PeterDarley/lightmotron/docs/df_player.png

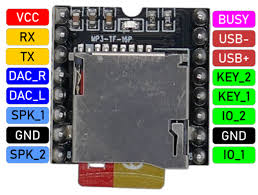
docs/df_player.png
