PeterDarley/lightmotron/docs/Logic Level Converter.png

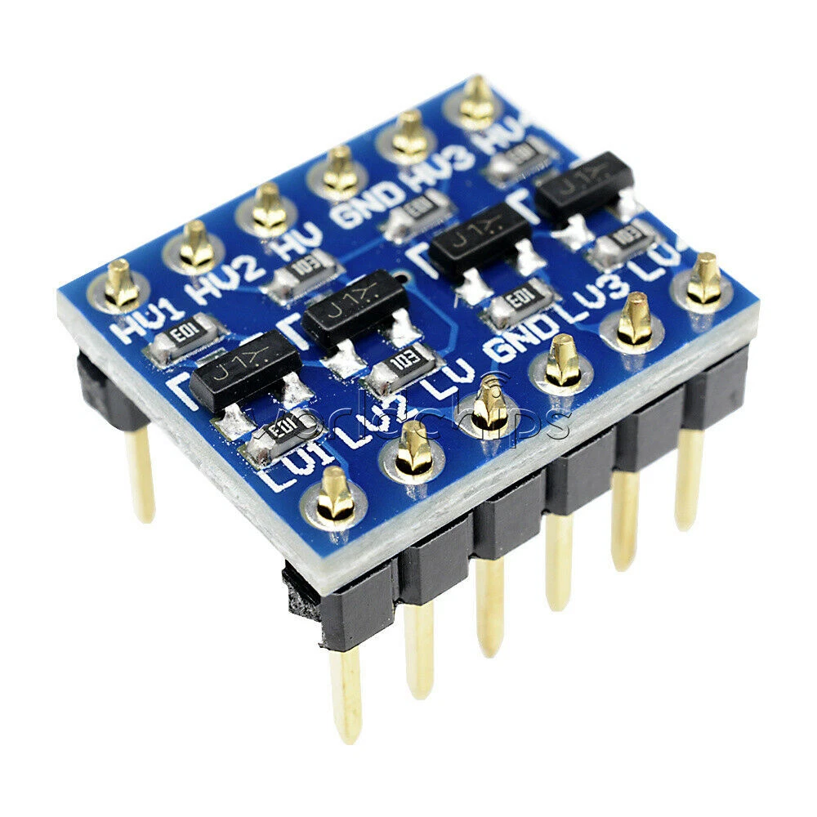
docs/Logic Level Converter.png
