PeterDarley/lightmotron/docs/single leds.png

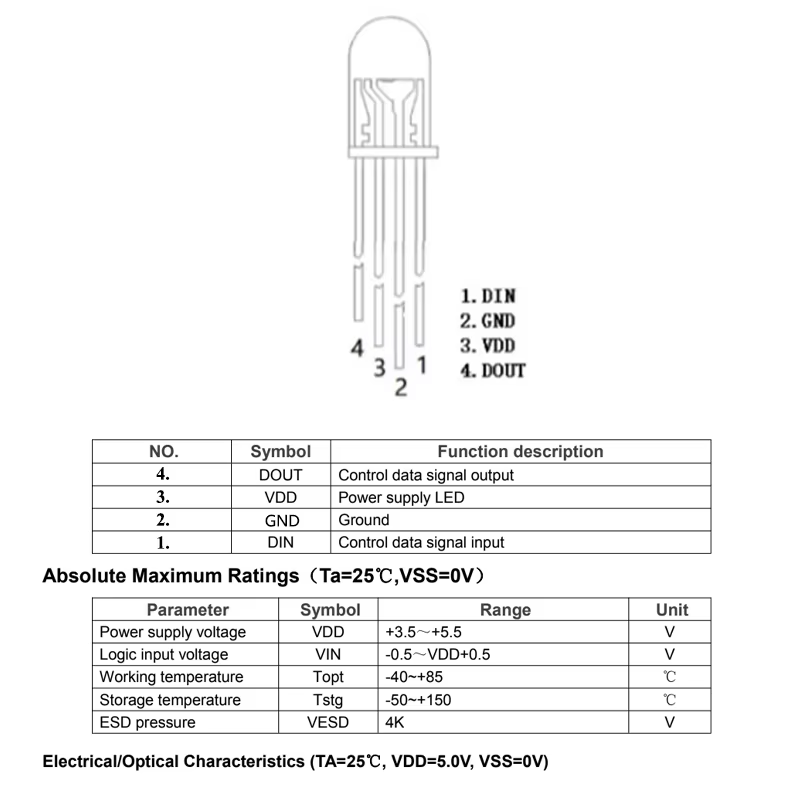
docs/single leds.png
