PeterDarley/lightmotron/docs/YD-ESP32-S3.jpg

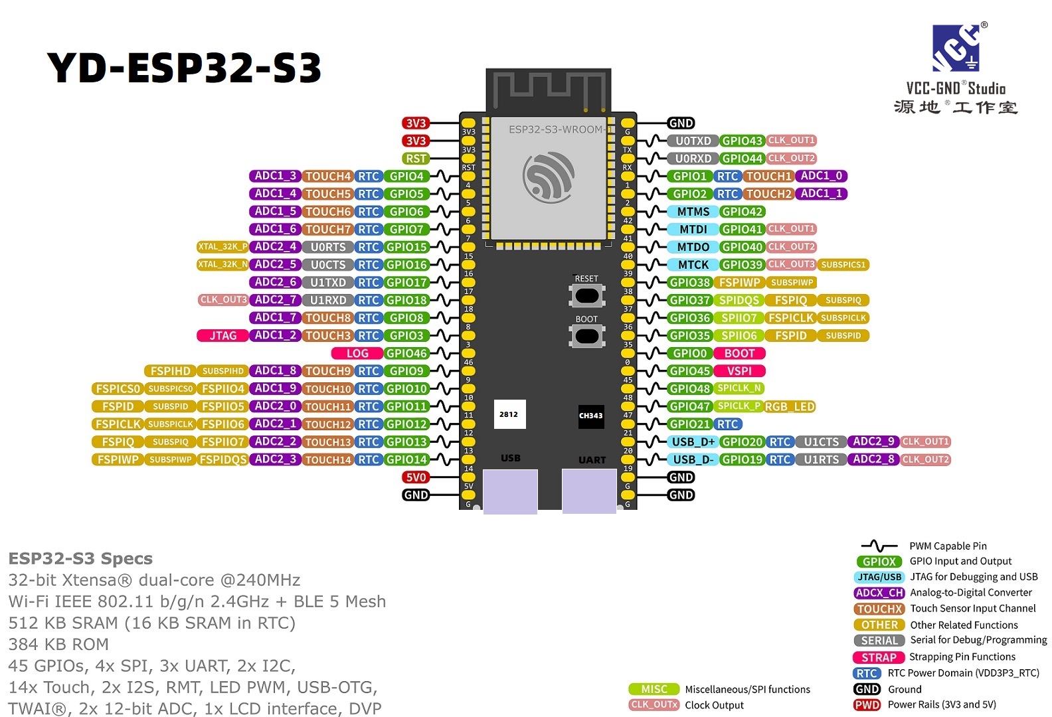
docs/YD-ESP32-S3.jpg
