PeterDarley/lightmotron/docs/bilboard wiring.jpg

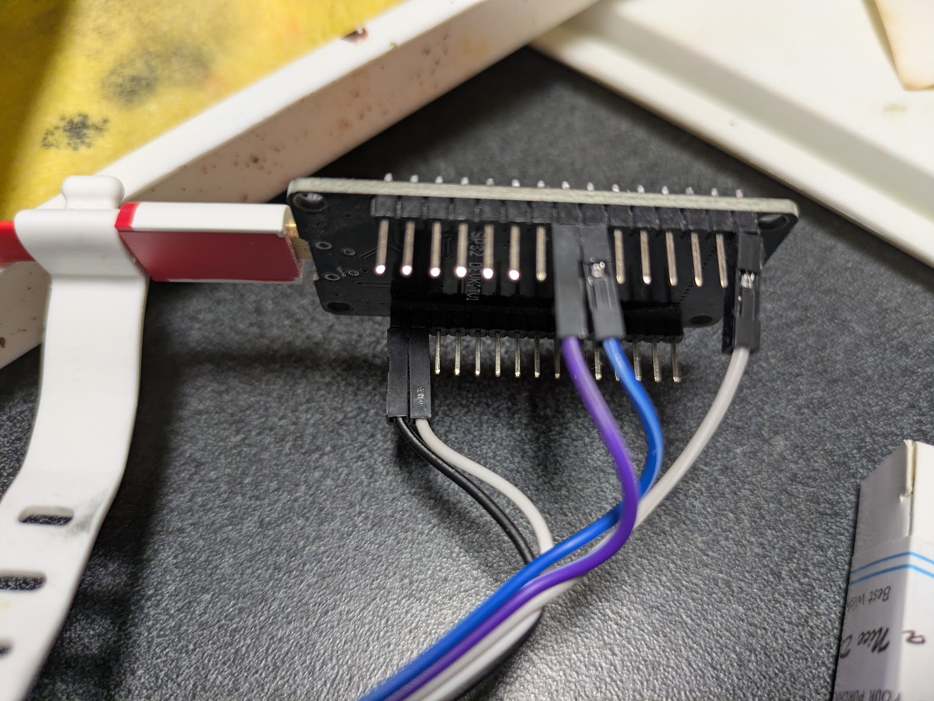
docs/bilboard wiring.jpg
