PeterDarley/lightmotron/docs/screenshots/setup-effects-edit.png

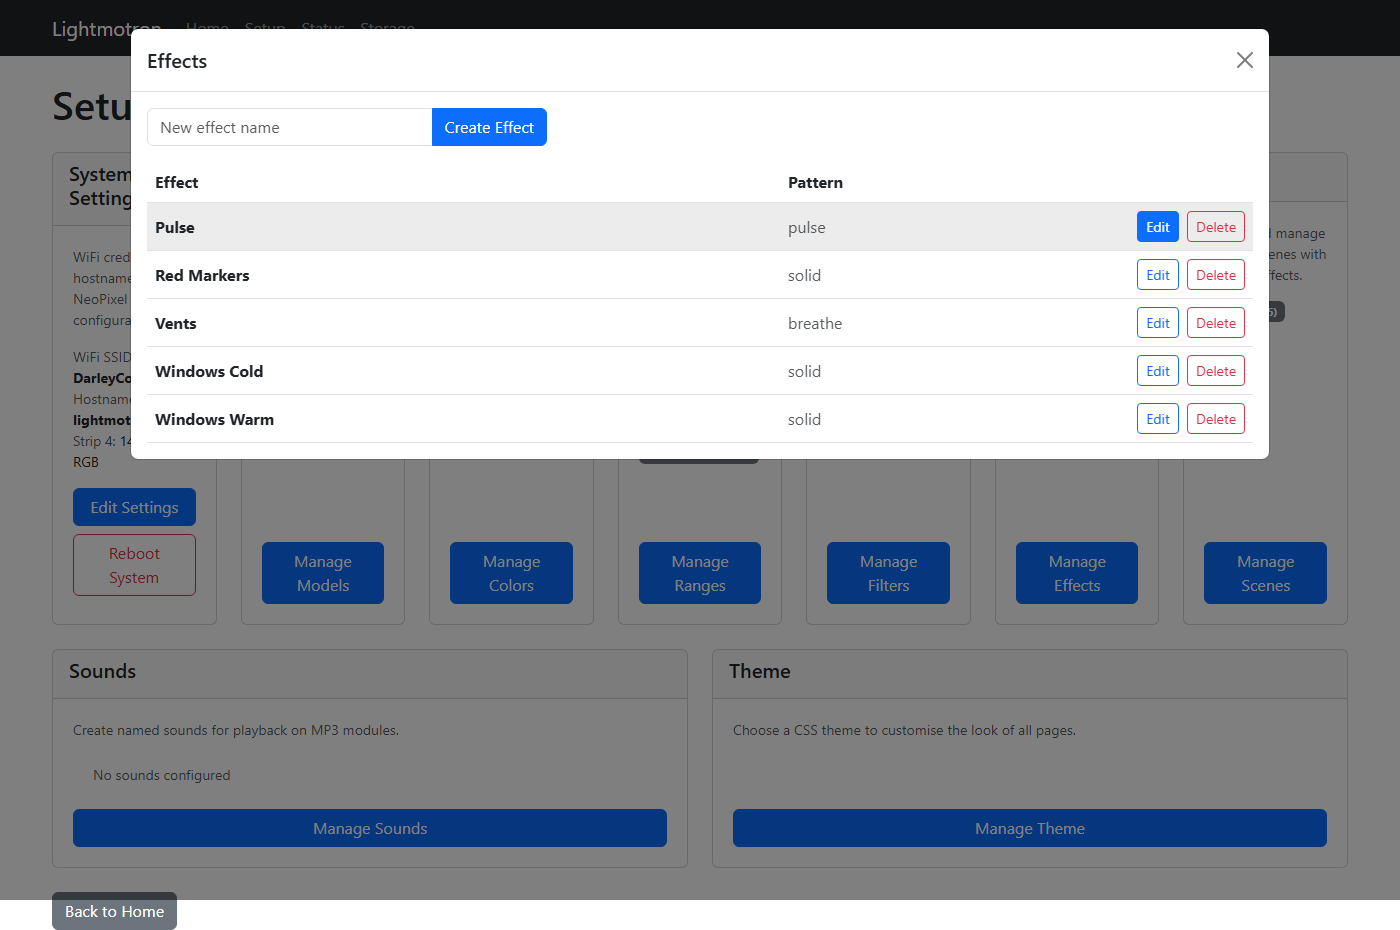
docs/screenshots/setup-effects-edit.png
