PeterDarley/lightmotron/docs/screenshots/setup-filters-edit.png

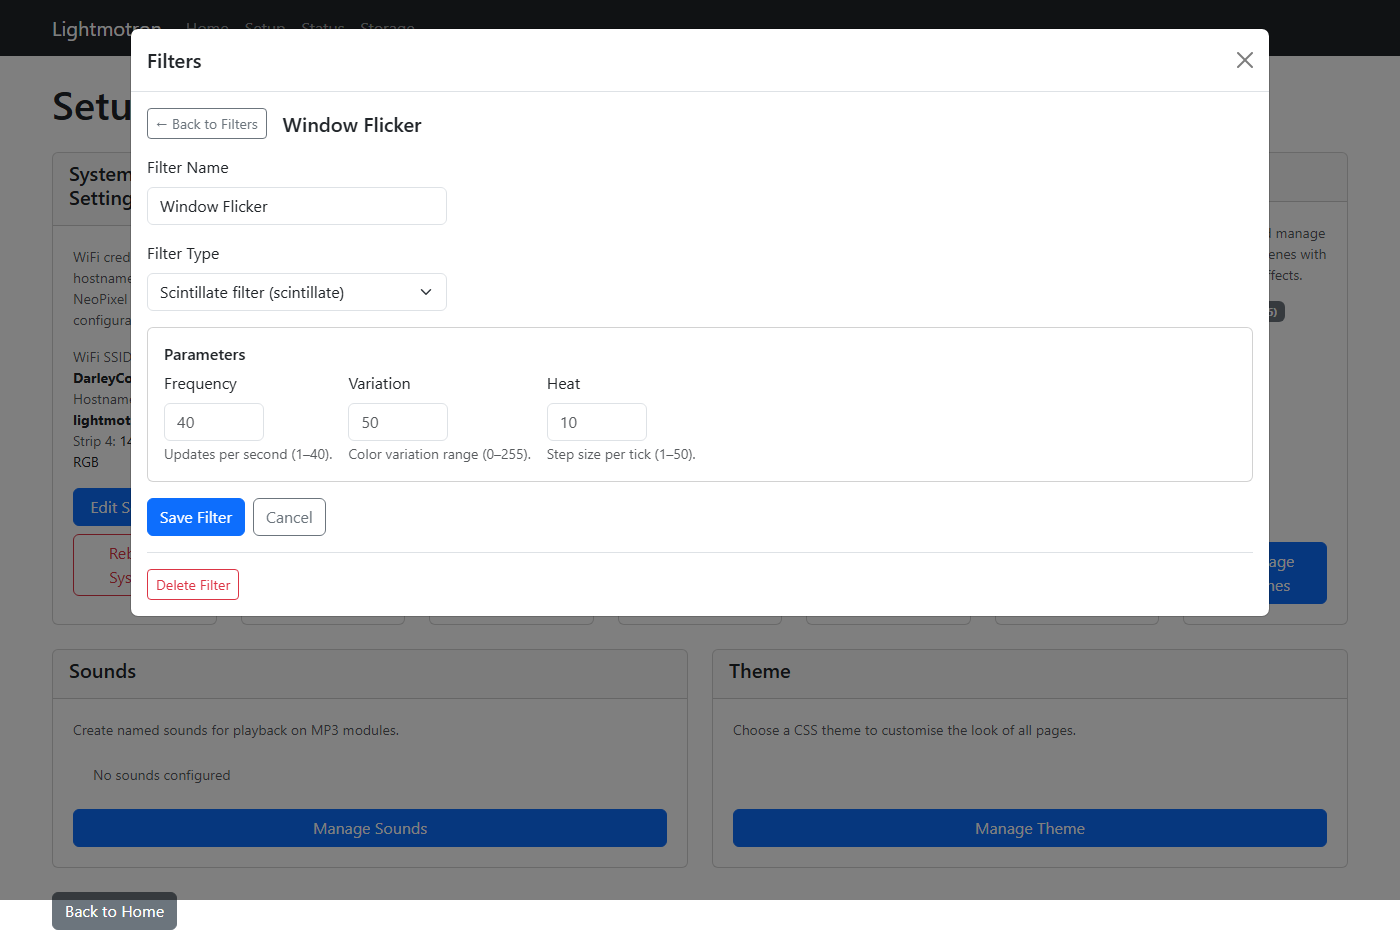
docs/screenshots/setup-filters-edit.png
