PeterDarley/lightmotron/docs/screenshots/setup-job-edit.png

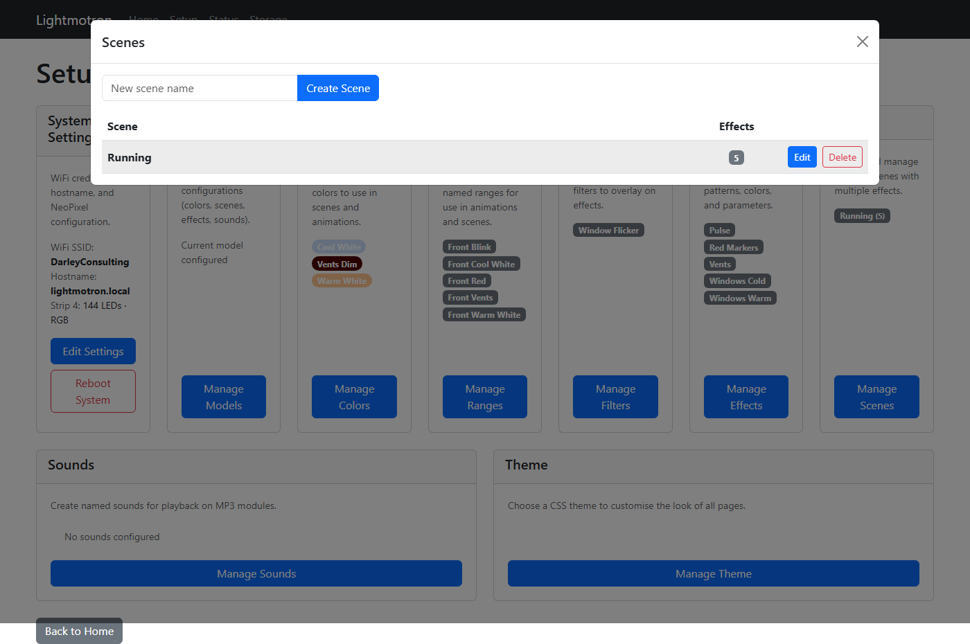
docs/screenshots/setup-job-edit.png
