PeterDarley/lightmotron/docs/screenshots/setup-ranges-edit.png

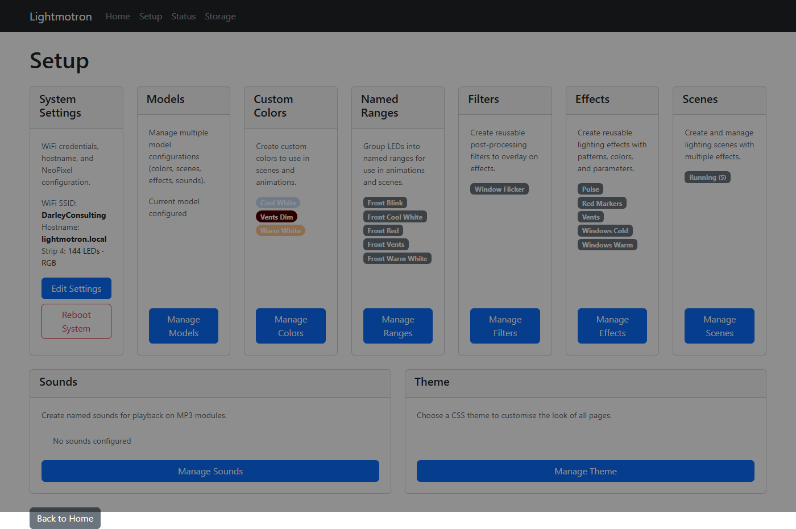
docs/screenshots/setup-ranges-edit.png
