PeterDarley/lightmotron/hardware/surface_mount/surface_mount.kicad_pcb

## KiCad design hardware/surface_mount/surface_mount.kicad_pcb (2026-11-10)

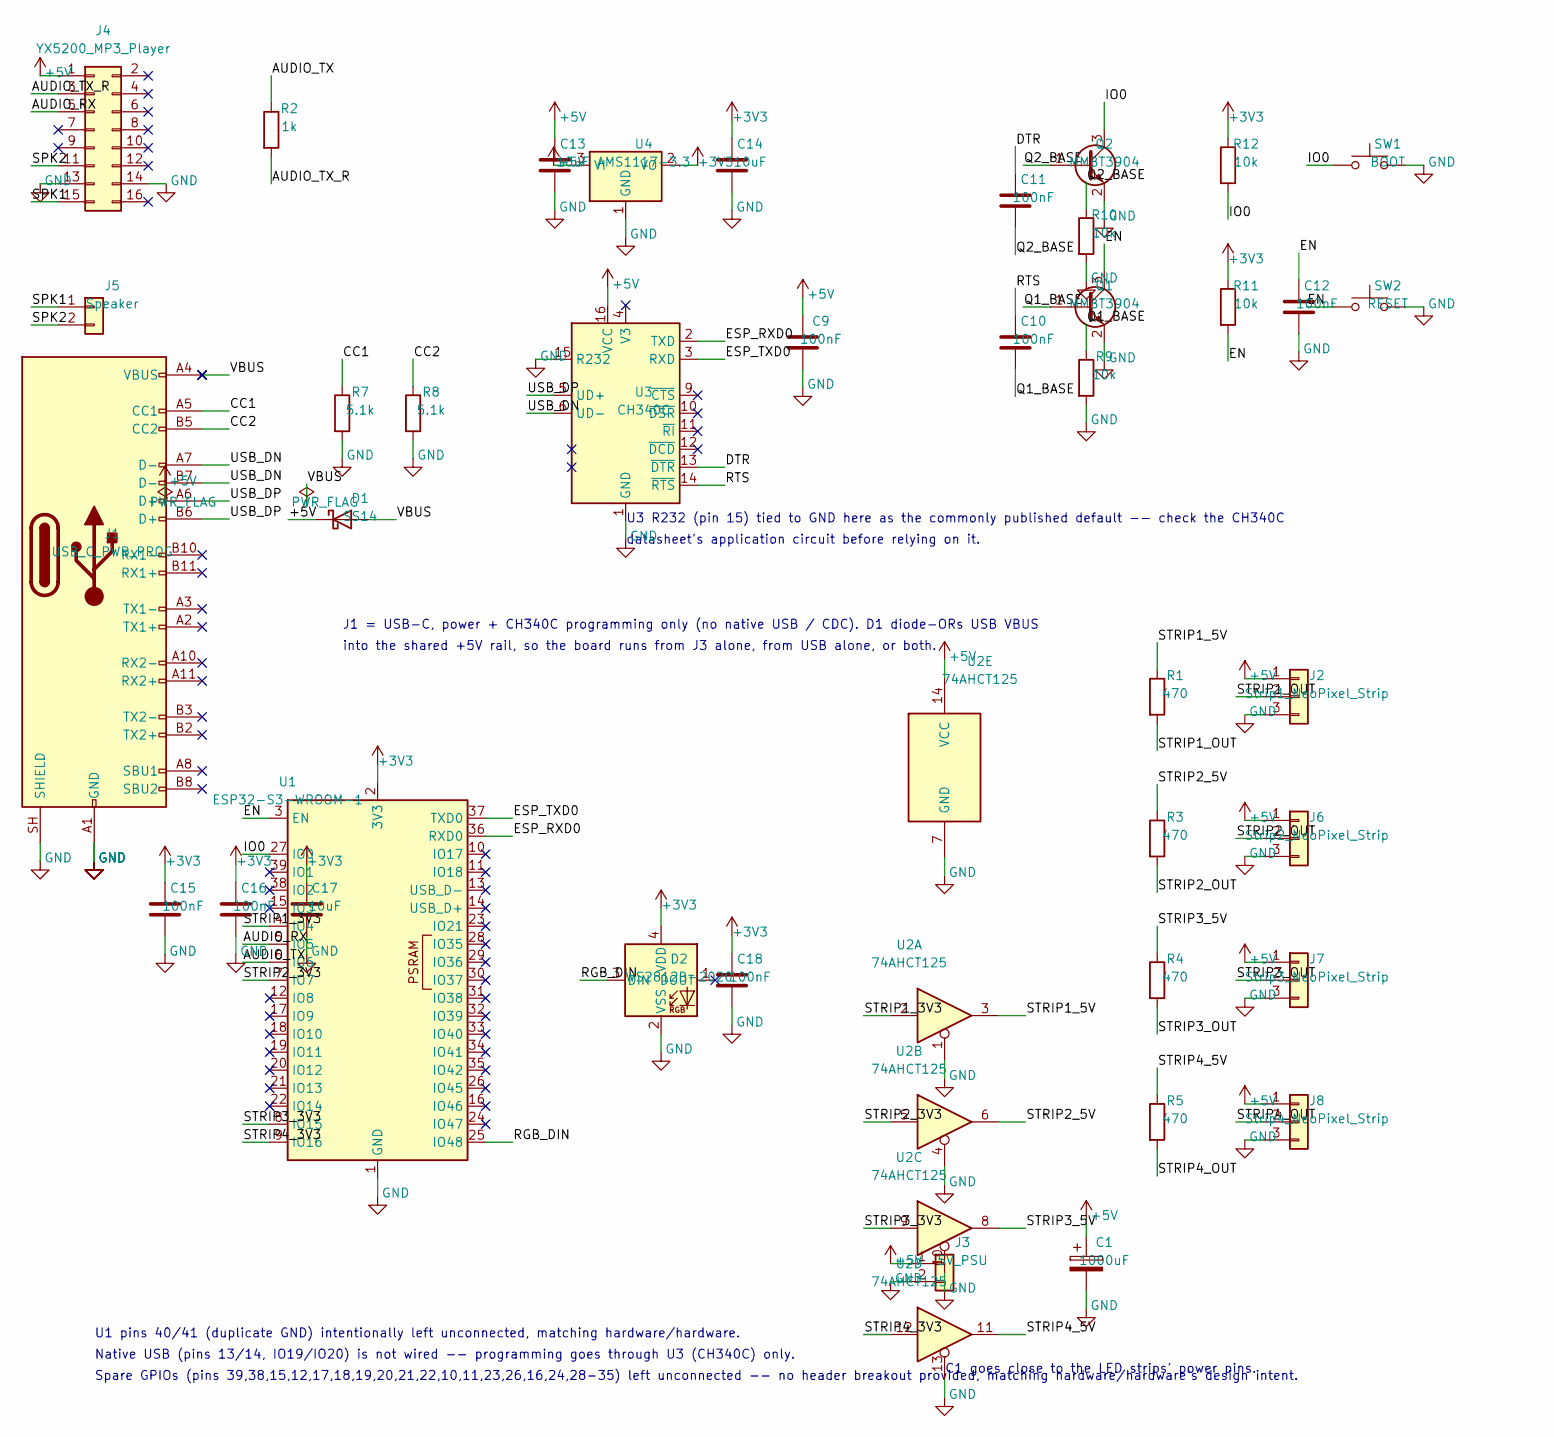
[picture p19: schematic surface_mount.kicad_sch]

Parts:
C1: 1000uF; CP_Elec_10x10.5
C9, C10, C11, C12, C15, C16, C18: 100nF; C_0603_1608Metric
C13, C14, C17: 10uF; C_0805_2012Metric
D1: SS14; D_SOD-123
D2: WS2812B-2020; LED_WS2812B-2020_PLCC4_2.0x2.0mm
J1: USB_C_PWR_PROG; USB_C_Receptacle_Amphenol_12401548E4-2A
J2: Strip1_NeoPixel_Strip; PinHeader_1x03_P2.54mm_Vertical
J3: 5V_PSU; PinHeader_1x02_P2.54mm_Vertical
J4: YX5200_MP3_Player; YX5200_DFPlayer_DIP16_W15.24mm
J5: Speaker; PinHeader_1x02_P2.54mm_Vertical
J6: Strip2_NeoPixel_Strip; PinHeader_1x03_P2.54mm_Vertical
J7: Strip3_NeoPixel_Strip; PinHeader_1x03_P2.54mm_Vertical
J8: Strip4_NeoPixel_Strip; PinHeader_1x03_P2.54mm_Vertical
Q1, Q2: MMBT3904; SOT-23
R1, R3, R4, R5: 470; R_0805_2012Metric
R2: 1k; R_0805_2012Metric
R7, R8: 5.1k; R_0805_2012Metric
R9, R10, R11, R12: 10k; R_0805_2012Metric
SW1: BOOT; Panasonic_EVQPUJ_EVQPUA
SW2: RESET; Panasonic_EVQPUJ_EVQPUA
U1: ESP32-S3-WROOM-1
U2: 74AHCT125; SOIC-14_3.9x8.7mm_P1.27mm
U3: CH340C; SOIC-16_3.9x9.9mm_P1.27mm
U4: AMS1117-3.3; SOT-223-3_TabPin2

Connections:
+3V3: C14.1, C15.1, C16.1, C17.1, C18.1, D2.4 (VDD), R11.1, R12.1, U1.2 (3V3), U4.2 (VO)
/AUDIO_RX: J4.5, U1.5 (IO5)
/AUDIO_TX: R2.1, U1.6 (IO6)
/AUDIO_TX_R: J4.3, R2.2
/CC1: J1.A5 (CC1), R7.1
/CC2: J1.B5 (CC2), R8.1
/DTR: C11.1, U3.13 (~DTR)
/EN: C12.1, Q1.3 (C), R11.2, SW2.1, U1.3 (EN)
/ESP_RXD0: U1.36 (RXD0), U3.2 (TXD)
/ESP_TXD0: U1.37 (TXD0), U3.3 (RXD)
/IO0: Q2.3 (C), R12.2, SW1.1, U1.27 (IO0)
/Q1_BASE: C10.2, Q1.1 (B), R9.1
/Q2_BASE: C11.2, Q2.1 (B), R10.1
/RGB_DIN: D2.3 (DIN), U1.25 (IO48)
/RTS: C10.1, U3.14 (~RTS)
/SPK1: J4.15, J5.1
/SPK2: J4.11, J5.2
/STRIP1_3V3: U1.4 (IO4), U2.2
/STRIP1_5V: R1.1, U2.3
/STRIP1_OUT: J2.2, R1.2
/STRIP2_3V3: U1.7 (IO7), U2.5
/STRIP2_5V: R3.1, U2.6
/STRIP2_OUT: J6.2, R3.2
/STRIP3_3V3: U1.8 (IO15), U2.9
/STRIP3_5V: R4.1, U2.8
/STRIP3_OUT: J7.2, R4.2
/STRIP4_3V3: U1.9 (IO16), U2.12
/STRIP4_5V: R5.1, U2.11
/STRIP4_OUT: J8.2, R5.2
/USB_DN: J1.A7 (D-), J1.B7 (D-), U3.6 (UD-)
/USB_DP: J1.A6 (D+), J1.B6 (D+), U3.5 (UD+)
GND: C1.2, C9.2, C12.2, C13.2, C14.2, C15.2, C16.2, C17.2, C18.2, D2.2 (VSS), J1.A1 (GND), J1.A12 (GND), J1.B1 (GND), J1.B12 (GND), J1.SH (SHIELD), J2.3, J3.2, J4.13, J4.14, J6.3, J7.3, J8.3, Q1.2 (E), Q2.2 (E), R7.2, R8.2, R9.2, R10.2, SW1.2, SW2.2, U1.1 (GND), U1.40 (GND), U1.41 (GND), U2.1, U2.4, U2.7 (GND), U2.10, U2.13, U3.1 (GND), U3.15 (R232), U4.1 (GND)

Notes on the sheet:
J1 = USB-C, power + CH340C programming only (no native USB / CDC). D1 diode-ORs USB VBUS
into the shared +5V rail, so the board runs from J3 alone, from USB alone, or both.
U3 R232 (pin 15) tied to GND here as the commonly published default -- check the CH340C
datasheet's application circuit before relying on it.
U1 pins 40/41 (duplicate GND) intentionally left unconnected, matching hardware/hardware.
Native USB (pins 13/14, IO19/IO20) is not wired -- programming goes through U3 (CH340C) only.
Spare GPIOs (pins 39,38,15,12,17,18,19,20,21,22,10,11,23,26,16,24,28-35) left unconnected -- no header breakout provided, matching hardware/hardware's design intent.
C1 goes close to the LED strips' power pins.

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
Board: 2 copper layers, 36 parts (0 on the bottom side), 26 nets, no tracks yet.
