PeterDarley/lightmotron/hardware/hardware/hardware.kicad_pcb

## KiCad design hardware/hardware/hardware.kicad_pcb (2026-11-10)

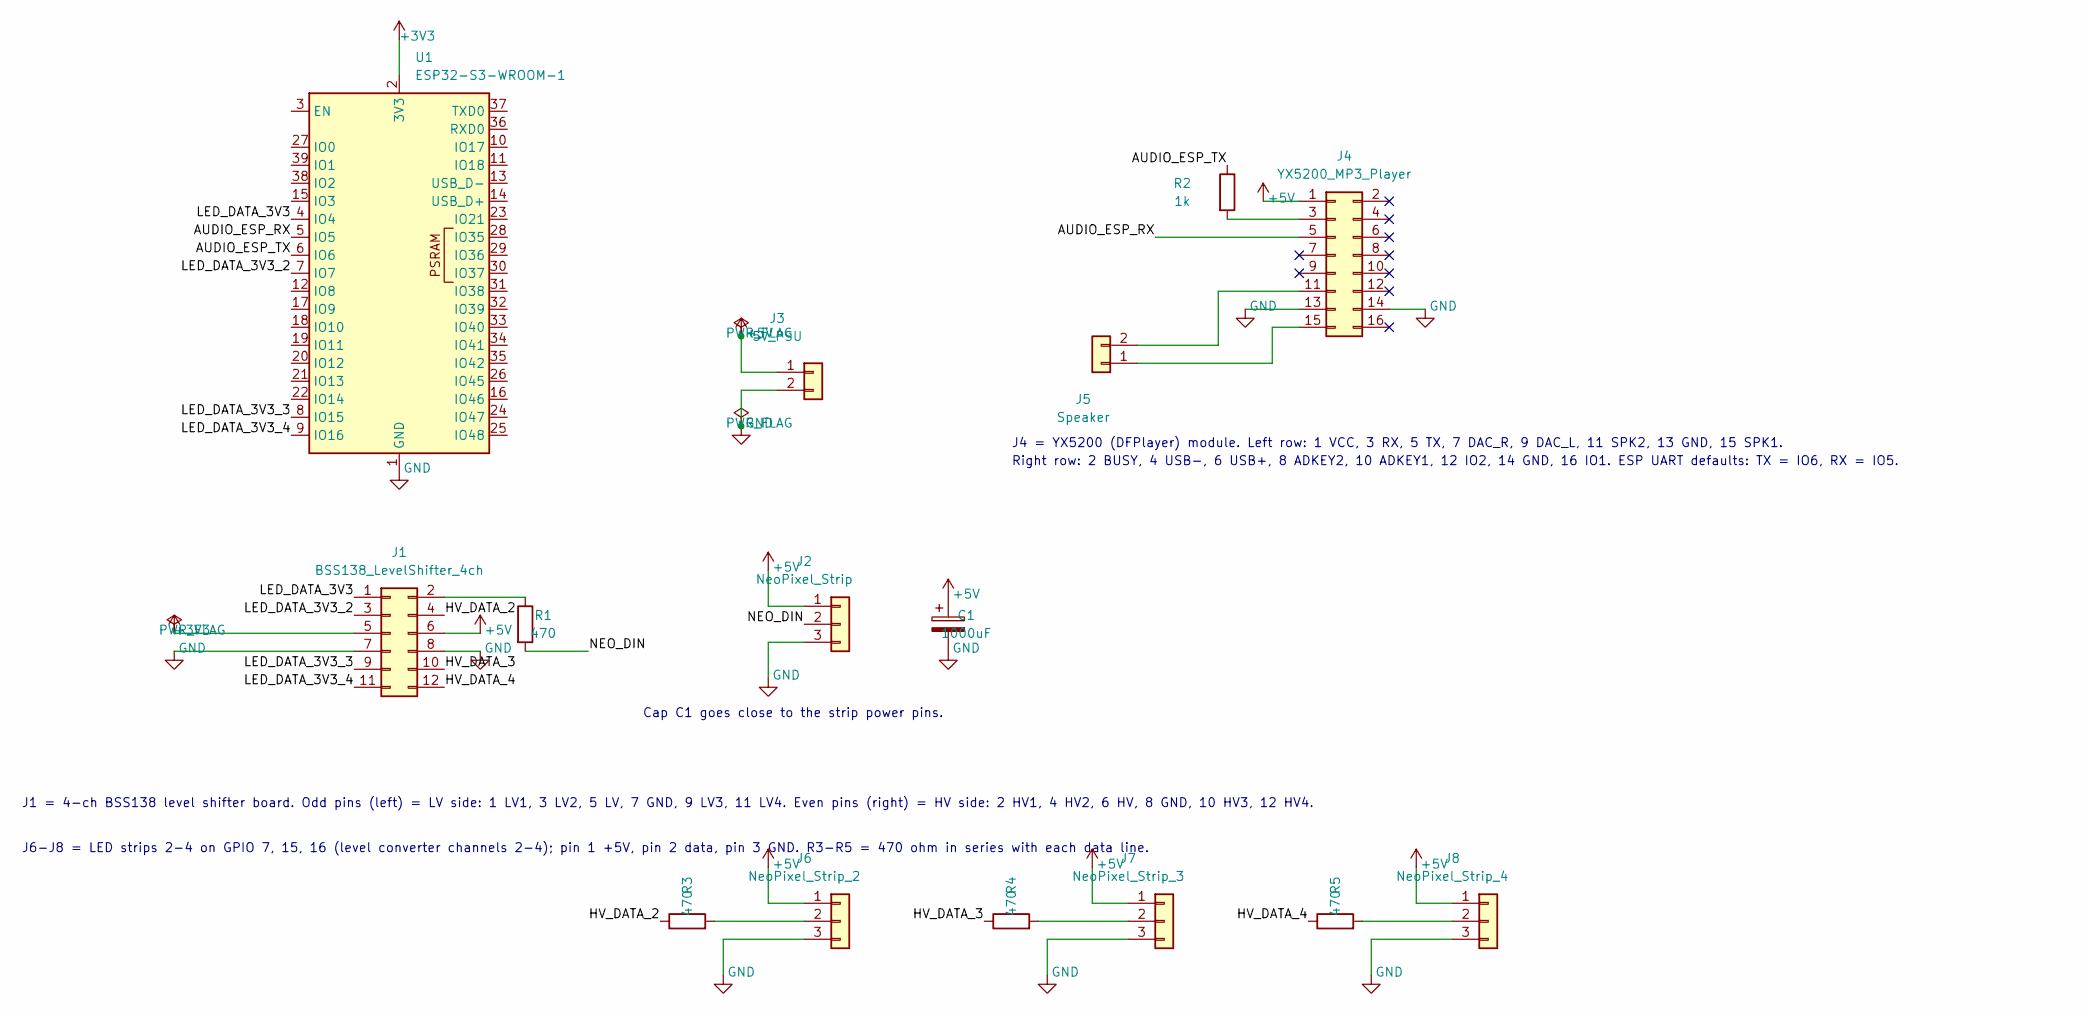
[picture p20: schematic hardware.kicad_sch]

Parts:
C1: 1000uF; CP_Radial_D10.0mm_P5.00mm
J1: BSS138_LevelShifter_4ch; BSS138_LevelShifter_4ch_2x06_P2.54mm_Row10.16mm
J2: NeoPixel_Strip; PinHeader_1x03_P2.54mm_Vertical
J3: 5V_PSU; PinHeader_1x02_P2.54mm_Vertical
J4: YX5200_MP3_Player; YX5200_DFPlayer_DIP16_W15.24mm
J5: Speaker; PinHeader_1x02_P2.54mm_Vertical
J6: NeoPixel_Strip_2; PinHeader_1x03_P2.54mm_Vertical
J7: NeoPixel_Strip_3; PinHeader_1x03_P2.54mm_Vertical
J8: NeoPixel_Strip_4; PinHeader_1x03_P2.54mm_Vertical
R1, R3, R4, R5: 470; R_Axial_DIN0207_L6.3mm_D2.5mm_P10.16mm_Horizontal
R2: 1k; R_Axial_DIN0207_L6.3mm_D2.5mm_P10.16mm_Horizontal
U1: ESP32-S3-WROOM-1; YD-ESP32-S3_DevKit_2x22_P2.54mm

Connections:
+3V3: J1.5, U1.2 (3V3)
+5V: C1.1, J1.6, J2.1, J3.1, J4.1, J6.1, J7.1, J8.1
/AUDIO_ESP_RX: J4.5, U1.5 (IO5)
/AUDIO_ESP_TX: R2.1, U1.6 (IO6)
/HV_DATA_2: J1.4, R3.1
/HV_DATA_3: J1.10, R4.1
/HV_DATA_4: J1.12, R5.1
/LED_DATA_3V3: J1.1, U1.4 (IO4)
/LED_DATA_3V3_2: J1.3, U1.7 (IO7)
/LED_DATA_3V3_3: J1.9, U1.8 (IO15)
/LED_DATA_3V3_4: J1.11, U1.9 (IO16)
/NEO_DIN: J2.2, R1.2
GND: C1.2, J1.7, J1.8, J2.3, J3.2, J4.13, J4.14, J6.3, J7.3, J8.3, U1.1 (GND), U1.40 (GND), U1.41 (GND)
unnamed: J1.2, R1.1
unnamed: J4.3, R2.2
unnamed: J4.11, J5.2
unnamed: J4.15, J5.1
unnamed: J6.2, R3.2
unnamed: J7.2, R4.2
unnamed: J8.2, R5.2

Notes on the sheet:
J1 = 4-ch BSS138 level shifter board. Odd pins (left) = LV side: 1 LV1, 3 LV2, 5 LV, 7 GND, 9 LV3, 11 LV4. Even pins (right) = HV side: 2 HV1, 4 HV2, 6 HV, 8 GND, 10 HV3, 12 HV4.
Cap C1 goes close to the strip power pins.
J4 = YX5200 (DFPlayer) module. Left row: 1 VCC, 3 RX, 5 TX, 7 DAC_R, 9 DAC_L, 11 SPK2, 13 GND, 15 SPK1.
Right row: 2 BUSY, 4 USB-, 6 USB+, 8 ADKEY2, 10 ADKEY1, 12 IO2, 14 GND, 16 IO1. ESP UART defaults: TX = IO6, RX = IO5.
J6-J8 = LED strips 2-4 on GPIO 7, 15, 16 (level converter channels 2-4); pin 1 +5V, pin 2 data, pin 3 GND. R3-R5 = 470 ohm in series with each data line.

Board: 2 copper layers, 15 parts (0 on the bottom side), 20 nets, no tracks yet.
