PeterDarley/lightmotron/c_project/components/lighting/lighting.c

#include "lighting.h"
#include "patterns.h"
#include "filters.h"
#include "effects.h"
#include "colors.h"
#include "named_ranges.h"
#include "range_topology.h"
#include "metadata.h"
#include "animation.h"
#include "persistent_dict.h"
#include "json_helpers.h"
#include "sound_manager.h"
#include "esp_log.h"
#include "freertos/FreeRTOS.h"
#include "freertos/semphr.h"

#include <string.h>
#include <stdlib.h>

static const char *TAG = "lighting";

/* LED/scene debug logging (below, in lighting_process_tick()) -- flip to 1 to
 * re-enable without having to reconstruct it. Added for LED hardware
 * bring-up, the stuck-scene-chain investigation, and the "first click
 * doesn't start the scene" report (root cause of the last one:
 * activate_scene() never taking lighting_mutex, see the "Create active
 * scene" comment below -- fixed and confirmed). Off by default again. */
#define LED_DEBUG_ENABLED 0

/* Heap-allocated (lands in external PSRAM via CONFIG_SPIRAM_USE_MALLOC,
 * since MAX_ACTIVE_SCENES * MAX_JOBS_PER_SCENE * MAX_LEDS target_indices
 * arrays are far too large for internal DRAM). */
static active_scene_t *active_scenes = NULL;
static int active_scene_count = 0;
static rgb_t logical_colors[MAX_LEDS];
static SemaphoreHandle_t lighting_mutex = NULL;
static bool initialized = false;

/* Pre-allocated buffers for tick processing (avoids per-frame stack/heap alloc) */
static led_output_t tick_output_buf[MAX_LEDS];
static rgb_t tick_filter_buf[MAX_LEDS];
static rgb_t tick_pattern_current_buf[MAX_LEDS];

esp_err_t lighting_init(void)
{
    if (initialized) return ESP_OK;

    active_scenes = calloc(MAX_ACTIVE_SCENES, sizeof(active_scene_t));
    if (!active_scenes) {
        ESP_LOGE(TAG, "Failed to allocate active_scenes (%u bytes)",
                 (unsigned)(MAX_ACTIVE_SCENES * sizeof(active_scene_t)));
        return ESP_ERR_NO_MEM;
    }

    lighting_mutex = xSemaphoreCreateMutex();
    if (!lighting_mutex) {
        ESP_LOGE(TAG, "Failed to create lighting_mutex");
        free(active_scenes);
        active_scenes = NULL;
        return ESP_ERR_NO_MEM;
    }
    memset(logical_colors, 0, sizeof(logical_colors));
    active_scene_count = 0;
    initialized = true;

    ESP_LOGI(TAG, "Lighting system initialized");
    return ESP_OK;
}

/**
 * Open the lighting-settings persistent store. Thin wrapper around the
 * shared STORAGE_LIGHTING_SETTINGS_FILE constant so every call site here
 * doesn't repeat the raw persistent_dict_open() call.
 */
static persistent_dict_t *open_lighting_store(void)
{
    return persistent_dict_open(STORAGE_LIGHTING_SETTINGS_FILE);
}

/**
 * Open the lighting settings store and return the currently-active model
 * object. Returns NULL if the store, models map, or current model is
 * missing.
 */
static cJSON *get_current_model_object(void)
{
    persistent_dict_t *lighting_store = open_lighting_store();
    if (!lighting_store) return NULL;

    cJSON *models = persistent_dict_get(lighting_store, "models");
    cJSON *current_name = persistent_dict_get(lighting_store, "current_model");
    if (!models || !current_name || !current_name->valuestring) return NULL;

    return cJSON_GetObjectItem(models, current_name->valuestring);
}

/**
 * Return true if every effect in the scene has an explicit cycle limit and
 * all of them have finished (mirrors Lighting._is_scene_finished()). A scene
 * with no cycle-limited effects at all (or none yet resolved) is never
 * considered finished.
 */
static bool scene_is_finished(const active_scene_t *scene)
{
    bool has_cycle_limited = false;

    for (int j = 0; j < scene->job_count; j++) {
        const active_job_t *job = &scene->jobs[j];
        if (job->target_count == 0) continue;

        if (job->cycles <= 0) {
            /* Infinite effect: scene is ongoing by design. */
            return false;
        }

        has_cycle_limited = true;
        if (!job->finished) return false;
    }

    return has_cycle_limited;
}

/**
 * Free a job's per-filter cJSON params/cached_params and null the pointers
 * out. Shared by every place that tears down a job's filter chain (a scene
 * finishing naturally, being explicitly removed, or all scenes being
 * cleared).
 */
static void free_job_filters(active_job_t *job)
{
    for (int f = 0; f < job->filter_count; f++) {
        if (job->filters[f].params) {
            cJSON_Delete(job->filters[f].params);
            job->filters[f].params = NULL;
        }
        if (job->filters[f].state.cached_params) {
            cJSON_Delete(job->filters[f].state.cached_params);
            job->filters[f].state.cached_params = NULL;
        }
        if (job->filters[f].state.per_led_deviation) {
            free(job->filters[f].state.per_led_deviation);
            job->filters[f].state.per_led_deviation = NULL;
            job->filters[f].state.per_led_deviation_count = 0;
        }
    }
}

/**
 * Resolve scene_name to an actual scene key, falling back to the model's
 * "default_scene" and then to the first defined scene (mirrors
 * Lighting.set_scene()'s None-name resolution). Returns NULL if no scene
 * could be resolved.
 */
static const char *resolve_scene_name(const cJSON *model, const char *scene_name, cJSON *scenes)
{
    if (scene_name) return scene_name;

    const char *default_scene = json_get_string(model, "default_scene", NULL);
    if (default_scene && cJSON_GetObjectItem(scenes, default_scene)) {
        return default_scene;
    }

    cJSON *first = scenes->child;
    return first ? first->string : NULL;
}

/**
 * Resolve one scene job entry (a named-effect reference plus overrides, or an
 * inline effect) into `job`. Shared by scene activation and by the live
 * refresh of running jobs below, so both build a job identically.
 */
static void resolve_job_entry(const cJSON *job_entry, const cJSON *effects_dict,
                              const cJSON *filters_dict, active_job_t *job)
{
    /* Check if this references a named effect or is inline */
    const char *effect_ref = json_get_string(job_entry, "effect", NULL);
    if (effect_ref && effects_dict) {
        cJSON *effect_def = cJSON_GetObjectItem(effects_dict, effect_ref);
        if (effect_def) {
            effect_resolve(effect_def, filters_dict, job);
        }
        /* Override with inline params */
        const char *target = json_get_string(job_entry, "target", NULL);
        if (target) {
            if (pattern_is_2d(job->pattern_name)) {
                if (strncmp(target, "named:", 6) == 0) {
                    range_topology_resolve(target + 6, job);
                } else {
                    job->target_count = 0;
                }
            } else {
                job->target_count = target_spec_resolve(target, job->target_indices, MAX_LEDS);
            }
        }
        int cycles = json_get_int(job_entry, "cycles", -1);
        if (cycles >= 0) job->cycles = cycles;

        const char *after = json_get_string(job_entry, "after", NULL);
        if (after) strncpy(job->after, after, sizeof(job->after) - 1);
        job->inherit_target = json_get_bool(job_entry, "inherit_target", false);
    } else {
        effect_resolve_inline(job_entry, filters_dict, job);
    }

    /* Set after effect_resolve()/effect_resolve_inline() -- both start
     * with memset(job, 0, sizeof(*job)), which would otherwise wipe this
     * right back out. Other jobs' "after" dependency lookups match on
     * this name (strcmp against scene->jobs[d].name), so it must survive
     * job resolution intact. */
    strncpy(job->name, job_entry->string, sizeof(job->name) - 1);
}

/* ---------------------------------------------------------------------
 * Live refresh of running jobs
 *
 * A running job holds a *resolved copy* of its scene entry, effect, filters
 * and colors, made when the scene started. Editing any of those in the Setup
 * UI only changes the stored settings, so without this a running scene kept
 * using its old copy until restarted. lighting_process_tick() compares the
 * lighting store's change counter (persistent_dict_version) every tick and,
 * when it moved, re-resolves every running job from the current settings and
 * merges the new *definition* into the live job -- keeping its *runtime*
 * state (start tick, finished flag, dependency state, per-filter animation
 * state) so nothing restarts.
 * ------------------------------------------------------------------- */

static active_job_t refresh_tmp;      /* scratch; only used with lighting_mutex held */
static persistent_dict_t *s_lighting_store_cached = NULL;
static uint32_t s_seen_settings_version = 0;

static void merge_job_definition(active_job_t *job, active_job_t *fresh)
{
    /* Filters: the old cJSON params are always replaced. Per-filter runtime
     * state (spike/dropout timing, sizzle/scintillate deviations) carries over
     * when the filter at the same position is still the same type, so a
     * parameter tweak doesn't reset the animation. A dropout's cached_params
     * is derived from params, so it's dropped to be rebuilt from the new ones. */
    for (int f = 0; f < job->filter_count; f++) {
        filter_state_t *old_state = &job->filters[f].state;
        if (job->filters[f].params) {
            cJSON_Delete(job->filters[f].params);
            job->filters[f].params = NULL;
        }
        if (old_state->cached_params) {
            cJSON_Delete(old_state->cached_params);
            old_state->cached_params = NULL;
        }

        bool carry = f < fresh->filter_count &&
                     strcmp(job->filters[f].filter_name, fresh->filters[f].filter_name) == 0;
        if (carry) {
            fresh->filters[f].state = *old_state; /* takes over per_led_deviation too */
        } else if (old_state->per_led_deviation) {
            free(old_state->per_led_deviation);
            old_state->per_led_deviation = NULL;
        }
    }
    memcpy(job->filters, fresh->filters, sizeof(job->filters));
    job->filter_count = fresh->filter_count;

    strncpy(job->pattern_name, fresh->pattern_name, sizeof(job->pattern_name) - 1);
    job->pattern_name[sizeof(job->pattern_name) - 1] = '\0';
    memcpy(job->colors, fresh->colors, sizeof(job->colors));
    job->color_count = fresh->color_count;
    job->duration = fresh->duration;
    job->cycles = fresh->cycles;
    job->period = fresh->period;
    job->width = fresh->width;
    job->number = fresh->number;
    job->reverse = fresh->reverse;
    job->saturation = fresh->saturation;
    job->cooling = fresh->cooling;
    job->sparking = fresh->sparking;
    job->spacing = fresh->spacing;

    /* A job that already adopted its predecessor's target at runtime
     * (inherit_target) keeps that; otherwise take the freshly resolved one
     * (covers edits to named ranges too). */
    if (!(job->inherit_target && !job->after_pending)) {
        memcpy(job->target_indices, fresh->target_indices, sizeof(job->target_indices));
        job->target_count = fresh->target_count;
    }
    /* Untouched on purpose: name, after, after_pending, start_tick, finished,
     * cycles_completed, retained_* (all runtime/identity state). */
}

/* Called with lighting_mutex held. */
static void refresh_running_jobs_locked(void)
{
    cJSON *model = get_current_model_object();
    if (!model) return;

    cJSON *scenes = cJSON_GetObjectItem(model, "scenes");
    cJSON *effects_dict = cJSON_GetObjectItem(model, "effects");
    cJSON *filters_dict = cJSON_GetObjectItem(model, "filters");
    if (!scenes) return;

    int refreshed = 0;
    for (int s = 0; s < active_scene_count; s++) {
        active_scene_t *scene = &active_scenes[s];
        if (!scene->active) continue;

        cJSON *scene_def = cJSON_GetObjectItem(scenes, scene->name);
        if (!scene_def || !cJSON_IsObject(scene_def)) continue; /* deleted/renamed: keep running as-is */

        for (int j = 0; j < scene->job_count; j++) {
            active_job_t *job = &scene->jobs[j];
            if (job->finished) continue;

            cJSON *entry = cJSON_GetObjectItem(scene_def, job->name);
            if (!entry) continue; /* job removed/renamed: keep running as-is */

            memset(&refresh_tmp, 0, sizeof(refresh_tmp));
            resolve_job_entry(entry, effects_dict, filters_dict, &refresh_tmp);
            if (refresh_tmp.pattern_name[0] == '\0') continue; /* effect no longer resolvable */

            merge_job_definition(job, &refresh_tmp);
            refreshed++;
        }
    }

    if (refreshed > 0) {
        ESP_LOGI(TAG, "Settings changed: refreshed %d running job(s) in place", refreshed);
    }
}

/**
 * Load a scene from storage and activate it. Pass NULL for scene_name to
 * resolve the model's default (or first) scene.
 */
static esp_err_t activate_scene(const char *scene_name)
{
    if (active_scene_count >= MAX_ACTIVE_SCENES) {
        ESP_LOGW(TAG, "Max active scenes reached");
        return ESP_ERR_NO_MEM;
    }

    cJSON *model = get_current_model_object();
    if (!model) return ESP_FAIL;

    cJSON *scenes = cJSON_GetObjectItem(model, "scenes");
    if (!scenes) return ESP_FAIL;

    scene_name = resolve_scene_name(model, scene_name, scenes);
    if (!scene_name) {
        ESP_LOGW(TAG, "No scene available to activate");
        return ESP_ERR_NOT_FOUND;
    }

    cJSON *scene_def = cJSON_GetObjectItem(scenes, scene_name);
    if (!scene_def || !cJSON_IsObject(scene_def)) {
        ESP_LOGW(TAG, "Scene not found: %s", scene_name);
        return ESP_ERR_NOT_FOUND;
    }

    /* Handle scene metadata (kills, sounds) */
    scene_metadata_t meta;
    metadata_get_scene(scene_name, &meta);

    /* Kill other scenes */
    for (int k = 0; k < meta.kills_count; k++) {
        lighting_remove_scene(meta.kills[k]);
    }

    /* Also always kill any existing instance of THIS scene before adding a
     * new one -- re-activating a scene should restart it, not stack a
     * second concurrent copy on top (observed: the Home page's "immediate"
     * scene buttons use action=add, which never clears a same-name
     * instance on its own; a scene would need to list its own name in its
     * own "kills", which none do and shouldn't need to). Confirmed on
     * hardware: two "Startup" instances both active simultaneously,
     * fighting over the same LEDs. */
    lighting_remove_scene(scene_name);

    /* Stop sounds on start */
    for (int s = 0; s < meta.stop_sounds_on_start_count; s++) {
        sound_manager_stop(meta.stop_sounds_on_start[s]);
    }

    /* Play scene sound */
    if (meta.sound[0] != '\0') {
        sound_manager_play(meta.sound, 0);
    }

    /* Create active scene. From here on, active_scenes[]/active_scene_count
     * are mutated -- lighting_process_tick() (running concurrently on the
     * animation task, potentially a different CPU core) reads and writes
     * this same state every tick under lighting_mutex, as do
     * lighting_clear_scenes()/lighting_remove_scene()/
     * lighting_get_active_scenes(). activate_scene() never took this mutex
     * for its own writes -- a genuine data race, confirmed by a "Scene
     * activated ... active_scene_count now 1" log immediately followed
     * (within the same second, no explicit kill logged in between) by
     * active_scenes=0, with a job whose cycle count couldn't legitimately
     * have finished that fast. Locked here, AFTER the kills loop above
     * (which itself takes this same mutex per-call via
     * lighting_remove_scene() -- wrapping the kills loop too would
     * self-deadlock on this non-recursive mutex). Re-checks the capacity
     * guard from the top of this function, now atomically with the write,
     * since the earlier check was just an unsynchronized fast-path read. */
    xSemaphoreTake(lighting_mutex, portMAX_DELAY);

    if (active_scene_count >= MAX_ACTIVE_SCENES) {
        xSemaphoreGive(lighting_mutex);
        ESP_LOGW(TAG, "Max active scenes reached");
        return ESP_ERR_NO_MEM;
    }

    active_scene_t *scene = &active_scenes[active_scene_count];
    memset(scene, 0, sizeof(active_scene_t));
    strncpy(scene->name, scene_name, sizeof(scene->name) - 1);
    scene->active = true;

    /* Resolve all jobs in the scene */
    cJSON *effects_dict = cJSON_GetObjectItem(model, "effects");
    cJSON *filters_dict = cJSON_GetObjectItem(model, "filters");
    cJSON *job_entry = scene_def->child;
    int job_idx = 0;
    uint32_t current_tick = animation_get_tick();

    while (job_entry && job_idx < MAX_JOBS_PER_SCENE) {
        active_job_t *job = &scene->jobs[job_idx];

        resolve_job_entry(job_entry, effects_dict, filters_dict, job);

        /* Non-"after" jobs start counting from this scene's activation tick,
         * matching Lighting.set_scene()/add_scene() tracking scene start
         * ticks in Python. "after"-dependent jobs get their start_tick
         * reassigned lazily once their dependency finishes (see
         * lighting_process_tick()). */
        job->start_tick = current_tick;
        job->after_pending = (job->after[0] != '\0');
        job->cycles_completed = 0;
        job->finished = false;
        job_idx++;
        job_entry = job_entry->next;
    }

    scene->job_count = job_idx;
    active_scene_count++;

    xSemaphoreGive(lighting_mutex);

    ESP_LOGI(TAG, "Scene activated: %s (%d jobs) at slot %d, active_scene_count now %d",
             scene_name, job_idx, active_scene_count - 1, active_scene_count);
    for (int j = 0; j < job_idx; j++) {
        active_job_t *job = &scene->jobs[j];
        ESP_LOGI(TAG, "  job '%s': pattern=%s target_count=%d after='%s' cycles=%d",
                 job->name, job->pattern_name, job->target_count, job->after, job->cycles);
    }
    return ESP_OK;
}

void lighting_process_tick(uint32_t tick)
{
    if (!initialized) return;

    /* Scene names to activate once the mutex is released — completed scenes'
     * trigger_scenes_on_completion lists (mirrors effects.py's process_tick,
     * which calls add_scene() for each trigger before remove_scene()).
     * Deferred because activate_scene() -> lighting_remove_scene() re-takes
     * the non-recursive lighting mutex. Flat capped list keeps animation-task
     * stack usage modest. */
    char pending_triggers[8][64];
    int pending_trigger_count = 0;

    xSemaphoreTake(lighting_mutex, portMAX_DELAY);

    /* Pick up saved edits to scenes/effects/filters/colors/ranges without
     * restarting anything -- see "Live refresh of running jobs" above. */
    if (!s_lighting_store_cached) s_lighting_store_cached = open_lighting_store();
    uint32_t settings_version = persistent_dict_version(s_lighting_store_cached);
    if (settings_version != s_seen_settings_version) {
        s_seen_settings_version = settings_version;
        refresh_running_jobs_locked();
    }

    for (int s = 0; s < active_scene_count; s++) {
        active_scene_t *scene = &active_scenes[s];
        if (!scene->active) continue;

        bool all_finished = true;
        bool has_cycle_limited = false;

        for (int j = 0; j < scene->job_count; j++) {
            active_job_t *job = &scene->jobs[j];
            if (job->finished) continue;
            if (job->target_count == 0) continue;

            /* Check 'after' dependency */
            if (job->after[0] != '\0') {
                active_job_t *dep_job = NULL;
                for (int d = 0; d < scene->job_count; d++) {
                    if (strcmp(scene->jobs[d].name, job->after) == 0) {
                        dep_job = &scene->jobs[d];
                        break;
                    }
                }
                if (!dep_job || !dep_job->finished) {
                    all_finished = false;
                    continue;
                }
                /* Start this job now, the first time its dependency finishes */
                if (job->after_pending) {
                    job->start_tick = tick;
                    job->after_pending = false;

                    /* inherit_target: adopt the finished predecessor's
                     * resolved target (mirrors Python's passthrough in
                     * effects.py — the predecessor's target may itself have
                     * been inherited, so chains A->B->C work). */
                    if (job->inherit_target && dep_job->target_count > 0) {
                        memcpy(job->target_indices, dep_job->target_indices,
                               sizeof(job->target_indices));
                        job->target_count = dep_job->target_count;
                    }
                }
            }

            /* Calculate local tick */
            uint32_t local_tick = tick - job->start_tick;

            /* Check cycle completion */
            if (job->cycles > 0) {
                has_cycle_limited = true;
                int duration = job->duration > 0 ? job->duration : 40;
                int ticks_per_cycle = duration;
                if (job->period > 0) ticks_per_cycle = job->period;

                int current_cycle = (int)(local_tick / ticks_per_cycle);
#if LED_DEBUG_ENABLED
                if (tick % 40 == 0) {
                    ESP_LOGI(TAG, "  cycle-check '%s': tick=%u start_tick=%u local_tick=%u "
                             "duration=%d ticks_per_cycle=%d current_cycle=%d/%d",
                             job->name, (unsigned)tick, (unsigned)job->start_tick, (unsigned)local_tick,
                             duration, ticks_per_cycle, current_cycle, job->cycles);
                }
#endif
                if (current_cycle >= job->cycles) {
                    job->finished = true;
                    continue;
                }
                all_finished = false;
            } else {
                /* Infinite effect */
                all_finished = false;
            }

            /* Build the current (previous-frame) logical color for each of
             * this job's targets, in target order. Needed by patterns that
             * fade from the prior frame (wave/cylon/phaser_strip), mirroring
             * Lighting.get_logical_color() usage in patterns.py. */
            for (int i = 0; i < job->target_count && i < MAX_LEDS; i++) {
                int idx = job->target_indices[i];
                tick_pattern_current_buf[i] = (idx >= 0 && idx < MAX_LEDS) ? logical_colors[idx] : (rgb_t){0, 0, 0};
            }

            /* Execute pattern */
            pattern_fn_t pattern_fn = pattern_get(job->pattern_name);
            int output_count = pattern_fn(job, local_tick, tick_pattern_current_buf, tick_output_buf, MAX_LEDS);

            /* Apply filters. Filters key their timing off the effect's own
             * local_tick (ticks since this job/effect started), matching
             * Python's effects.py process_tick() which calls filter_func(...,
             * tick_number=local_tick) - not the global animation tick. */
            for (int f = 0; f < job->filter_count; f++) {
                filter_fn_t filter_fn = filter_get(job->filters[f].filter_name);

                /* Build current colors array for the target LEDs */
                for (int o = 0; o < output_count; o++) {
                    int idx = tick_output_buf[o].led_index;
                    if (idx >= 0 && idx < MAX_LEDS) {
                        tick_filter_buf[o] = logical_colors[idx];
                    } else {
                        tick_filter_buf[o] = (rgb_t){0, 0, 0};
                    }
                }

                filter_fn(job->filters[f].params, tick_output_buf, tick_filter_buf,
                          output_count, &job->filters[f].state, local_tick);
            }

            /* Update logical colors */
            for (int o = 0; o < output_count; o++) {
                int idx = tick_output_buf[o].led_index;
                if (idx >= 0 && idx < MAX_LEDS) {
                    logical_colors[idx] = tick_output_buf[o].color;
                }
            }
        }

        /* Auto-remove scene if all cycle-limited effects are done */
        if (has_cycle_limited && all_finished) {
            ESP_LOGI(TAG, "Scene completed: %s", scene->name);

            /* Handle stop_sounds_on_end */
            scene_metadata_t meta;
            metadata_get_scene(scene->name, &meta);
            for (int ss = 0; ss < meta.stop_sounds_on_end_count; ss++) {
                sound_manager_stop(meta.stop_sounds_on_end[ss]);
            }

            /* Queue trigger_scenes_on_completion for activation after the
             * mutex is released. */
            for (int t = 0; t < meta.trigger_scenes_on_completion_count &&
                            pending_trigger_count < 8; t++) {
                strncpy(pending_triggers[pending_trigger_count],
                        meta.trigger_scenes_on_completion[t],
                        sizeof(pending_triggers[0]) - 1);
                pending_triggers[pending_trigger_count][sizeof(pending_triggers[0]) - 1] = '\0';
                pending_trigger_count++;
            }

            /* Free filter resources */
            for (int j = 0; j < scene->job_count; j++) {
                free_job_filters(&scene->jobs[j]);
            }

            scene->active = false;
        }
    }

    /* Write logical colors to LED buffer */
    int total = leds_total_count();
    for (int i = 0; i < total && i < MAX_LEDS; i++) {
        leds_set_pixel_rgb(i, logical_colors[i]);
    }

    /* Debug: log the first 5 LEDs' computed color every 40 ticks (~1s at the
     * 40Hz tick rate), plus how many scenes are active and how many LEDs the
     * driver thinks are configured -- the three things most likely to
     * explain "nothing lights up" on a first hardware bring-up: no scene
     * running, zero/misconfigured LED count, or colors that are correctly
     * black at this instant vs. a strip that just isn't responding. Disabled
     * by default (see LED_DEBUG_ENABLED above) now that both bring-up issues
     * it was added for are resolved. */
#if LED_DEBUG_ENABLED
    if (tick % 40 == 0) {
        int debug_count = total < 5 ? total : 5;
        /* static: this file pre-allocates its per-tick scratch buffers
         * (tick_output_buf etc. above) rather than putting them on the
         * animation task's stack -- these debug buffers need the same
         * treatment. A stack-local version of these two overflowed that
         * task's stack (canary-triggered panic at this same log line). */
        static char debug_buf[160];
        int debug_off = 0;
        for (int i = 0; i < debug_count; i++) {
            debug_off += snprintf(debug_buf + debug_off, sizeof(debug_buf) - debug_off,
                                   "%s[%d]=(%u,%u,%u)", i == 0 ? "" : " ", i,
                                   logical_colors[i].r, logical_colors[i].g, logical_colors[i].b);
        }

        /* Per-scene/per-job status: name, then each job as "name:F" (finished),
         * "name:P" (waiting on an unfinished 'after' dependency), or "name:."
         * (running/rendering this tick) -- lets a stuck 'after' chain (a job
         * that never reaches finished, so everything chained after it waits
         * forever) be spotted directly from the log instead of guessed at. */
        static char scenes_buf[400];
        int scenes_off = 0;
        for (int s = 0; s < active_scene_count && scenes_off < (int)sizeof(scenes_buf) - 1; s++) {
            active_scene_t *scene = &active_scenes[s];
            if (!scene->active) continue;
            scenes_off += snprintf(scenes_buf + scenes_off, sizeof(scenes_buf) - scenes_off,
                                    "%s[%s:", scenes_off == 0 ? "" : " ", scene->name);
            for (int j = 0; j < scene->job_count && scenes_off < (int)sizeof(scenes_buf) - 1; j++) {
                active_job_t *job = &scene->jobs[j];
                char state = job->finished ? 'F' : (job->after_pending ? 'P' : '.');
                scenes_off += snprintf(scenes_buf + scenes_off, sizeof(scenes_buf) - scenes_off,
                                        "%s%s:%c", j == 0 ? "" : ",", job->name, state);
            }
            scenes_off += snprintf(scenes_buf + scenes_off, sizeof(scenes_buf) - scenes_off, "]");
        }

        ESP_LOGI(TAG, "LED debug: tick=%u active_scenes=%d leds=%d %s",
                 (unsigned)tick, active_scene_count, total, debug_buf);
        if (scenes_off > 0) {
            ESP_LOGI(TAG, "Scene debug: %s", scenes_buf);
        }
    }
#endif /* LED_DEBUG_ENABLED */

    /* Compact active scenes (remove inactive) */
    int write_idx = 0;
    for (int i = 0; i < active_scene_count; i++) {
        if (active_scenes[i].active) {
            if (write_idx != i) {
                active_scenes[write_idx] = active_scenes[i];
            }
            write_idx++;
        }
    }
    active_scene_count = write_idx;

    xSemaphoreGive(lighting_mutex);

    /* Fire completion triggers now that the mutex is free. activate_scene()
     * validates the name against the model's scenes itself, matching Python's
     * `if trigger_scene_name in self.settings.get("scenes", {})` guard. */
    for (int t = 0; t < pending_trigger_count; t++) {
        esp_err_t trigger_err = lighting_add_scene(pending_triggers[t]);
        if (trigger_err != ESP_OK) {
            ESP_LOGW(TAG, "Failed to trigger scene '%s' on completion (err=%d)",
                     pending_triggers[t], (int)trigger_err);
        }
    }
}

esp_err_t lighting_set_scene(const char *scene_name)
{
    lighting_clear_scenes();
    return activate_scene(scene_name);
}

esp_err_t lighting_add_scene(const char *scene_name)
{
    return activate_scene(scene_name);
}

esp_err_t lighting_activate_boot_scenes(void)
{
    cJSON *model = get_current_model_object();
    if (!model) return ESP_FAIL;

    cJSON *scenes = cJSON_GetObjectItem(model, "scenes");
    if (!scenes) return ESP_FAIL;
    cJSON *scene_settings = cJSON_GetObjectItem(model, "scene_settings");

    char boot_scenes[MAX_ACTIVE_SCENES][64];
    int boot_scene_count = 0;

    for (cJSON *scene = scenes->child; scene && boot_scene_count < MAX_ACTIVE_SCENES; scene = scene->next) {
        cJSON *meta = scene_settings ? cJSON_GetObjectItem(scene_settings, scene->string) : NULL;
        if (meta && json_get_bool(meta, "active_on_boot", false)) {
            strncpy(boot_scenes[boot_scene_count], scene->string, sizeof(boot_scenes[0]) - 1);
            boot_scenes[boot_scene_count][sizeof(boot_scenes[0]) - 1] = '\0';
            boot_scene_count++;
        }
    }

    if (boot_scene_count == 0) {
        /* No scene explicitly marked -- fall back to the model's
         * "default_scene"/first-scene resolution, matching
         * Lighting._activate_boot_scenes()'s Python behavior for installs
         * that haven't touched this setting yet. */
        return lighting_set_scene(NULL);
    }

    /* Sorted for determinism (matches Python's sorted() list) -- only
     * actually observable if MAX_ACTIVE_SCENES is hit and some get
     * dropped, but cheap to keep in parity regardless. */
    for (int i = 1; i < boot_scene_count; i++) {
        char key[64];
        strncpy(key, boot_scenes[i], sizeof(key));
        int j = i - 1;
        while (j >= 0 && strcmp(boot_scenes[j], key) > 0) {
            strncpy(boot_scenes[j + 1], boot_scenes[j], sizeof(boot_scenes[0]));
            j--;
        }
        strncpy(boot_scenes[j + 1], key, sizeof(boot_scenes[0]));
    }

    esp_err_t ret = lighting_set_scene(boot_scenes[0]);
    for (int i = 1; i < boot_scene_count; i++) {
        esp_err_t add_ret = lighting_add_scene(boot_scenes[i]);
        if (add_ret != ESP_OK) ret = add_ret;
    }
    return ret;
}

esp_err_t lighting_remove_scene(const char *scene_name)
{
    if (!scene_name) return ESP_ERR_INVALID_ARG;

    xSemaphoreTake(lighting_mutex, portMAX_DELAY);

    bool found = false;
    for (int i = 0; i < active_scene_count; i++) {
        if (strcmp(active_scenes[i].name, scene_name) == 0) {
            found = true;
            ESP_LOGI(TAG, "lighting_remove_scene('%s'): found at slot %d, was_active=%d",
                     scene_name, i, active_scenes[i].active);
            /* Free filter params and cached state */
            for (int j = 0; j < active_scenes[i].job_count; j++) {
                free_job_filters(&active_scenes[i].jobs[j]);
            }
            active_scenes[i].active = false;
            break;
        }
    }
    if (!found) {
        ESP_LOGD(TAG, "lighting_remove_scene('%s'): not in active_scenes (%d entries)",
                 scene_name, active_scene_count);
    }

    xSemaphoreGive(lighting_mutex);
    return ESP_OK;
}

int lighting_get_active_scenes(char names[][64], int max_count)
{
    xSemaphoreTake(lighting_mutex, portMAX_DELAY);
    int count = 0;
    for (int i = 0; i < active_scene_count && count < max_count; i++) {
        if (active_scenes[i].active) {
            strncpy(names[count], active_scenes[i].name, 63);
            count++;
        }
    }
    xSemaphoreGive(lighting_mutex);
    return count;
}

void lighting_clear_scenes(void)
{
    xSemaphoreTake(lighting_mutex, portMAX_DELAY);
    for (int i = 0; i < active_scene_count; i++) {
        for (int j = 0; j < active_scenes[i].job_count; j++) {
            free_job_filters(&active_scenes[i].jobs[j]);
        }
    }
    active_scene_count = 0;
    memset(active_scenes, 0, sizeof(active_scenes));
    xSemaphoreGive(lighting_mutex);
}

void lighting_all_dark(void)
{
    xSemaphoreTake(lighting_mutex, portMAX_DELAY);
    for (int i = 0; i < active_scene_count; i++) {
        for (int j = 0; j < active_scenes[i].job_count; j++) {
            free_job_filters(&active_scenes[i].jobs[j]);
        }
        active_scenes[i].active = false;
    }
    active_scene_count = 0;
    /* Scenes only ever write the LEDs they target, and the tick loop pushes
     * logical_colors to the strip every tick regardless of what's running --
     * so with nothing running, zeroing this leaves every LED off. */
    memset(logical_colors, 0, sizeof(logical_colors));
    xSemaphoreGive(lighting_mutex);
    ESP_LOGI(TAG, "All Dark: cleared all running scenes, LEDs set to 0,0,0");
}

rgb_t *lighting_get_logical_colors(void)
{
    return logical_colors;
}

int lighting_get_targets(const char *spec, int *indices, int max_indices)
{
    return target_spec_resolve(spec, indices, max_indices);
}

rgb_t lighting_get_color(const char *spec)
{
    return color_resolve(spec);
}

rgb_t lighting_get_color_json(const cJSON *color_spec)
{
    return color_resolve_json(color_spec);
}

cJSON *lighting_get_model_names(void)
{
    persistent_dict_t *lighting_store = open_lighting_store();
    if (!lighting_store) return cJSON_CreateArray();

    cJSON *models = persistent_dict_get(lighting_store, "models");
    if (!models || !cJSON_IsObject(models)) return cJSON_CreateArray();

    cJSON *names = cJSON_CreateArray();
    cJSON *child = models->child;
    while (child) {
        cJSON_AddItemToArray(names, cJSON_CreateString(child->string));
        child = child->next;
    }
    return names;
}

const char *lighting_get_current_model(void)
{
    persistent_dict_t *lighting_store = open_lighting_store();
    if (!lighting_store) return "Model";

    cJSON *current = persistent_dict_get(lighting_store, "current_model");
    if (current && current->valuestring) return current->valuestring;
    return "Model";
}

esp_err_t lighting_set_current_model(const char *model_name)
{
    persistent_dict_t *lighting_store = open_lighting_store();
    if (!lighting_store) return ESP_FAIL;

    cJSON *val = cJSON_CreateString(model_name);
    persistent_dict_set(lighting_store, "current_model", val);
    persistent_dict_mark_dirty(lighting_store); persistent_dict_save(lighting_store);
    return ESP_OK;
}

cJSON *lighting_get_settings(void)
{
    persistent_dict_t *lighting_store = open_lighting_store();
    if (!lighting_store) return NULL;

    cJSON *models = persistent_dict_get(lighting_store, "models");
    const char *current = lighting_get_current_model();
    if (!models || !current) return NULL;

    return cJSON_GetObjectItem(models, current);
}

esp_err_t lighting_create_model(const char *model_name, bool copy_from_current)
{
    /* Mirrors Lighting.create_model(): a new model either starts as a
     * minimal empty scaffold, or deep-copies the allowed keys from the
     * currently active model. */
    if (!model_name || model_name[0] == '\0') return ESP_ERR_INVALID_ARG;

    persistent_dict_t *lighting_store = open_lighting_store();
    if (!lighting_store) return ESP_FAIL;

    cJSON *models = persistent_dict_get(lighting_store, "models");
    if (!models || !cJSON_IsObject(models)) return ESP_FAIL;

    if (cJSON_GetObjectItem(models, model_name)) {
        ESP_LOGW(TAG, "Model already exists: %s", model_name);
        return ESP_ERR_INVALID_STATE;
    }

    cJSON *new_model = cJSON_CreateObject();

    if (copy_from_current) {
        cJSON *current_name = persistent_dict_get(lighting_store, "current_model");
        cJSON *current_model = (current_name && current_name->valuestring)
            ? cJSON_GetObjectItem(models, current_name->valuestring) : NULL;

        static const char *allowed_keys[] = {
            "default_scene", "scenes", "named_ranges", "effects",
            "filters", "custom_colors", "scene_settings",
        };
        for (size_t i = 0; i < sizeof(allowed_keys) / sizeof(allowed_keys[0]); i++) {
            cJSON *src = current_model ? cJSON_GetObjectItem(current_model, allowed_keys[i]) : NULL;
            if (src) {
                cJSON_AddItemToObject(new_model, allowed_keys[i], cJSON_Duplicate(src, 1));
            } else if (strcmp(allowed_keys[i], "default_scene") == 0) {
                cJSON_AddItemToObject(new_model, allowed_keys[i], cJSON_CreateNull());
            } else {
                cJSON_AddItemToObject(new_model, allowed_keys[i], cJSON_CreateObject());
            }
        }
    } else {
        cJSON_AddItemToObject(new_model, "default_scene", cJSON_CreateNull());
        cJSON_AddItemToObject(new_model, "scenes", cJSON_CreateObject());
        cJSON_AddItemToObject(new_model, "named_ranges", cJSON_CreateObject());
        cJSON_AddItemToObject(new_model, "effects", cJSON_CreateObject());
        cJSON_AddItemToObject(new_model, "filters", cJSON_CreateObject());
        cJSON_AddItemToObject(new_model, "custom_colors", cJSON_CreateObject());
        cJSON_AddItemToObject(new_model, "scene_settings", cJSON_CreateObject());
    }

    cJSON_AddItemToObject(models, model_name, new_model);
    persistent_dict_mark_dirty(lighting_store);
    return persistent_dict_save(lighting_store);
}

esp_err_t lighting_delete_model(const char *model_name)
{
    /* Mirrors Lighting.delete_model(): refuses to delete the active model. */
    if (!model_name) return ESP_ERR_INVALID_ARG;

    persistent_dict_t *lighting_store = open_lighting_store();
    if (!lighting_store) return ESP_FAIL;

    cJSON *current_name = persistent_dict_get(lighting_store, "current_model");
    if (current_name && current_name->valuestring && strcmp(current_name->valuestring, model_name) == 0) {
        ESP_LOGW(TAG, "Cannot delete the currently active model: %s", model_name);
        return ESP_ERR_INVALID_STATE;
    }

    cJSON *models = persistent_dict_get(lighting_store, "models");
    if (!models || !cJSON_GetObjectItem(models, model_name)) {
        return ESP_ERR_NOT_FOUND;
    }

    cJSON_DeleteItemFromObject(models, model_name);
    persistent_dict_mark_dirty(lighting_store);
    return persistent_dict_save(lighting_store);
}

esp_err_t lighting_rename_model(const char *old_name, const char *new_name)
{
    /* Mirrors Lighting.rename_model(): updates current_model too if the
     * renamed model was the active one. */
    if (!old_name || !new_name || new_name[0] == '\0') return ESP_ERR_INVALID_ARG;

    persistent_dict_t *lighting_store = open_lighting_store();
    if (!lighting_store) return ESP_FAIL;

    cJSON *models = persistent_dict_get(lighting_store, "models");
    if (!models) return ESP_FAIL;

    if (!cJSON_GetObjectItem(models, old_name)) return ESP_ERR_NOT_FOUND;
    if (cJSON_GetObjectItem(models, new_name)) return ESP_ERR_INVALID_STATE;

    cJSON *detached = cJSON_DetachItemFromObject(models, old_name);
    cJSON_AddItemToObject(models, new_name, detached);

    cJSON *current_name = persistent_dict_get(lighting_store, "current_model");
    if (current_name && current_name->valuestring && strcmp(current_name->valuestring, old_name) == 0) {
        persistent_dict_set(lighting_store, "current_model", cJSON_CreateString(new_name));
    }

    persistent_dict_mark_dirty(lighting_store);
    return persistent_dict_save(lighting_store);
}

/* Estimated worst-case LED current across all saved scenes, in amps (LEDs
 * only, not the system allowance). For each LED, takes the brightest colour
 * any scene's job drives onto it (channel sum, scaled by the brightness
 * multiplier), then sums the per-LED draw. Full white on one pixel is
 * 3 x 20mA = 60mA, so a channel value of 255 is 20mA. */
#define PER_CHANNEL_AMPS 0.02f

static uint16_t peak_channel_sum[MAX_LEDS];
static active_job_t estimate_job;

float lighting_estimate_led_amps(void)
{
    cJSON *model = get_current_model_object();
    cJSON *scenes = model ? cJSON_GetObjectItem(model, "scenes") : NULL;
    cJSON *effects_dict = model ? cJSON_GetObjectItem(model, "effects") : NULL;
    cJSON *filters_dict = model ? cJSON_GetObjectItem(model, "filters") : NULL;
    /* Read the just-saved strip count from storage rather than the LED
     * driver's live total, which only reflects the config as of the last
     * boot -- this lets the Status page's power estimate update the moment
     * settings are saved, without needing a reboot. */
    persistent_dict_t *sys_for_count = persistent_dict_open(STORAGE_SYSTEM_SETTINGS_FILE);
    cJSON *neopixels = sys_for_count ? persistent_dict_get(sys_for_count, "neopixels") : NULL;
    int total = leds_count_configured_total(neopixels);
    if (!scenes || total <= 0) return 0.0f;
    if (total > MAX_LEDS) total = MAX_LEDS;

    memset(peak_channel_sum, 0, sizeof(peak_channel_sum));

    for (cJSON *scene_def = scenes->child; scene_def; scene_def = scene_def->next) {
        if (!cJSON_IsObject(scene_def)) continue;
        for (cJSON *entry = scene_def->child; entry; entry = entry->next) {
            memset(&estimate_job, 0, sizeof(estimate_job));
            resolve_job_entry(entry, effects_dict, filters_dict, &estimate_job);
            if (estimate_job.pattern_name[0] == '\0') continue;

            int job_peak = 0;
            for (int c = 0; c < estimate_job.color_count; c++) {
                int sum = estimate_job.colors[c].r + estimate_job.colors[c].g + estimate_job.colors[c].b;
                if (sum > job_peak) job_peak = sum;
            }
            for (int t = 0; t < estimate_job.target_count; t++) {
                int idx = estimate_job.target_indices[t];
                if (idx >= 0 && idx < total && job_peak > peak_channel_sum[idx]) {
                    peak_channel_sum[idx] = (uint16_t)job_peak;
                }
            }
        }
    }

    /* Always assumes 100% brightness, whatever the home-page slider is set to,
     * so the figure is the worst case for the supply. */
    const float scale = 1.0f;
    float amps = 0.0f;
    for (int i = 0; i < total; i++) {
        amps += (float)peak_channel_sum[i] * scale * PER_CHANNEL_AMPS / 255.0f;
    }
    return amps;
}

/* Cached result of the last estimate. The estimate walks every scene, so it
 * only runs when a setting that feeds it is saved (or once at boot); the
 * status page reads these values instead of recalculating. */
static float cached_led_amps = 0.0f;
static float cached_supply_amps = DEFAULT_POWER_SUPPLY_AMPS;

void lighting_update_power_estimate(void)
{
    cached_led_amps = lighting_estimate_led_amps();
    cached_supply_amps = DEFAULT_POWER_SUPPLY_AMPS;
    persistent_dict_t *sys = persistent_dict_open(STORAGE_SYSTEM_SETTINGS_FILE);
    cJSON *supply = sys ? persistent_dict_get(sys, "power_supply_amps") : NULL;
    if (cJSON_IsNumber(supply)) cached_supply_amps = (float)supply->valuedouble;
}

float lighting_get_cached_led_amps(void) { return cached_led_amps; }
float lighting_get_cached_supply_amps(void) { return cached_supply_amps; }

/* Called on every save to the lighting or system settings. Refreshes the
 * cache, then logs the estimated peak draw (LEDs plus the 0.5A system
 * allowance) and checks it against the configured supply. */
void lighting_report_power_estimate(void)
{
    lighting_update_power_estimate();
    const float system_amps = 0.5f;
    float total_amps = cached_led_amps + system_amps;

    ESP_LOGI(TAG, "Estimated peak draw: LEDs %.2fA + system %.2fA = %.2fA (supply %.2fA)",
             cached_led_amps, system_amps, total_amps, cached_supply_amps);
    if (total_amps > cached_supply_amps) {
        ESP_LOGW(TAG, "Estimated peak draw %.2fA exceeds the %.2fA supply setting",
                 total_amps, cached_supply_amps);
    }
}
