PeterDarley/lightmotron/c_project/components/lighting/metadata.c

#include "metadata.h"
#include "persistent_dict.h"
#include "json_helpers.h"

#include <string.h>

void metadata_get_scene(const char *scene_name, scene_metadata_t *meta)
{
    if (!meta) return;
    memset(meta, 0, sizeof(scene_metadata_t));

    if (!scene_name) return;

    persistent_dict_t *lighting = persistent_dict_open(STORAGE_LIGHTING_SETTINGS_FILE);
    if (!lighting) return;

    cJSON *models = persistent_dict_get(lighting, "models");
    cJSON *current_name = persistent_dict_get(lighting, "current_model");
    if (!models || !current_name || !current_name->valuestring) return;

    cJSON *model = cJSON_GetObjectItem(models, current_name->valuestring);
    if (!model) return;

    cJSON *scene_settings = cJSON_GetObjectItem(model, "scene_settings");
    if (!scene_settings) return;

    cJSON *settings = cJSON_GetObjectItem(scene_settings, scene_name);
    if (!settings) return;

    /* Parse kills array */
    cJSON *kills = cJSON_GetObjectItem(settings, "kills");
    if (kills && cJSON_IsArray(kills)) {
        int size = cJSON_GetArraySize(kills);
        if (size > 8) size = 8;
        for (int i = 0; i < size; i++) {
            cJSON *item = cJSON_GetArrayItem(kills, i);
            if (item && item->valuestring) {
                strncpy(meta->kills[i], item->valuestring, 63);
                meta->kills_count++;
            }
        }
    }

    /* Parse sound */
    const char *sound = json_get_string(settings, "sound", NULL);
    if (sound) {
        strncpy(meta->sound, sound, sizeof(meta->sound) - 1);
    }

    /* Parse stop_sounds_on_start */
    cJSON *stop_start = cJSON_GetObjectItem(settings, "stop_sounds_on_start");
    if (stop_start && cJSON_IsArray(stop_start)) {
        int size = cJSON_GetArraySize(stop_start);
        if (size > 8) size = 8;
        for (int i = 0; i < size; i++) {
            cJSON *item = cJSON_GetArrayItem(stop_start, i);
            if (item && item->valuestring) {
                strncpy(meta->stop_sounds_on_start[i], item->valuestring, 63);
                meta->stop_sounds_on_start_count++;
            }
        }
    }

    /* Parse stop_sounds_on_end */
    cJSON *stop_end = cJSON_GetObjectItem(settings, "stop_sounds_on_end");
    if (stop_end && cJSON_IsArray(stop_end)) {
        int size = cJSON_GetArraySize(stop_end);
        if (size > 8) size = 8;
        for (int i = 0; i < size; i++) {
            cJSON *item = cJSON_GetArrayItem(stop_end, i);
            if (item && item->valuestring) {
                strncpy(meta->stop_sounds_on_end[i], item->valuestring, 63);
                meta->stop_sounds_on_end_count++;
            }
        }
    }

    /* Parse trigger_scenes_on_completion */
    cJSON *triggers = cJSON_GetObjectItem(settings, "trigger_scenes_on_completion");
    if (triggers && cJSON_IsArray(triggers)) {
        int size = cJSON_GetArraySize(triggers);
        if (size > 8) size = 8;
        for (int i = 0; i < size; i++) {
            cJSON *item = cJSON_GetArrayItem(triggers, i);
            if (item && item->valuestring) {
                strncpy(meta->trigger_scenes_on_completion[i], item->valuestring, 63);
                meta->trigger_scenes_on_completion_count++;
            }
        }
    }
}

/* Mirrors PATTERN_METADATA in lib/lighting/metadata.py exactly - name
 * spelling of required/optional params matters, since they are used
 * verbatim as web form field name suffixes (e.g. "pattern_param_width"). */
const pattern_metadata_t pattern_metadata_table[] = {
    {
        .name = "solid",
        .description = "Solid color",
        .required = {"target", "colors"},
        .required_count = 2,
        .optional = {0},
        .optional_count = 0,
        .color_count = 1,
    },
    {
        .name = "blink",
        .description = "Blinking color",
        .required = {"target", "colors"},
        .required_count = 2,
        .optional = {"duration", "frequency"},
        .optional_count = 2,
        .color_count = 2,
    },
    {
        .name = "pulse",
        .description = "Pulsing color",
        .required = {"target", "colors"},
        .required_count = 2,
        .optional = {"duration", "period"},
        .optional_count = 2,
        .color_count = 2,
    },
    {
        .name = "fade_in",
        .description = "Fade between two colors",
        .required = {"target", "colors"},
        .required_count = 2,
        .optional = {"duration"},
        .optional_count = 1,
        .color_count = 2,
    },
    {
        .name = "breathe",
        .description = "Breathing effect",
        .required = {"target", "colors"},
        .required_count = 2,
        .optional = {"duration"},
        .optional_count = 1,
        .color_count = 2,
    },
    {
        .name = "wave",
        .description = "Moving wave effect",
        .required = {"target", "colors"},
        .required_count = 2,
        .optional = {"duration", "number", "width", "reverse"},
        .optional_count = 4,
        .color_count = 2,
    },
    {
        .name = "cylon",
        .description = "Cylon bouncing effect",
        .required = {"target", "colors"},
        .required_count = 2,
        .optional = {"duration", "width"},
        .optional_count = 2,
        .color_count = 2,
    },
    {
        .name = "phaser_strip",
        .description = "Two waves from each end converging on a random meeting point",
        .required = {"target", "colors"},
        .required_count = 2,
        .optional = {"duration", "width"},
        .optional_count = 2,
        .color_count = 2,
    },
    {
        .name = "rainbow",
        .description = "Rainbow hue cycling across the strip",
        .required = {"target"},
        .required_count = 1,
        .optional = {"duration", "number", "saturation"},
        .optional_count = 3,
        .color_count = 0,
    },
    {
        .name = "color_wipe",
        .description = "Progressively fill then wipe with two colors",
        .required = {"target", "colors"},
        .required_count = 2,
        .optional = {"duration"},
        .optional_count = 1,
        .color_count = 2,
    },
    {
        .name = "fire",
        .description = "Flickering fire simulation",
        .required = {"target"},
        .required_count = 1,
        .optional = {"duration", "cooling", "sparking"},
        .optional_count = 3,
        .color_count = 0,
    },
    {
        .name = "gradient",
        .description = "Color gradient across the strip (optionally scrolling)",
        .required = {"target", "colors"},
        .required_count = 2,
        .optional = {"duration"},
        .optional_count = 1,
        .color_count = 2,
    },
    {
        .name = "warp_pulse",
        .description = "Pulse expanding from the center to both ends",
        .required = {"target", "colors"},
        .required_count = 2,
        .optional = {"period", "width"},
        .optional_count = 2,
        .color_count = 2,
    },
    {
        .name = "theater_chase",
        .description = "Evenly spaced dots marching along the strip",
        .required = {"target", "colors"},
        .required_count = 2,
        .optional = {"duration", "spacing", "width", "reverse"},
        .optional_count = 4,
        .color_count = 2,
    },
    {
        .name = "heartbeat",
        .description = "Double-thump heartbeat rhythm",
        .required = {"target", "colors"},
        .required_count = 2,
        .optional = {"period"},
        .optional_count = 1,
        .color_count = 2,
    },
    {
        .name = "bouncing_ball",
        .description = "A single LED bounces around the 2D LED grid, with a glow that falls off with distance",
        .required = {"target", "colors"},
        .required_count = 2,
        .optional = {"duration", "ball_radius"},
        .optional_count = 2,
        .color_count = 1,
        .dimensions = 2,
    },
    { .name = NULL },
};

/* Mirrors FILTER_METADATA in lib/lighting/metadata.py exactly. */
const filter_metadata_t filter_metadata_table[] = {
    {
        .name = "null",
        .description = "No filter",
        .optional = {0},
        .optional_count = 0,
    },
    {
        .name = "sizzle",
        .description = "Sizzle filter",
        .optional = {"frequency", "variation_percent", "heat"},
        .optional_count = 3,
    },
    {
        .name = "scintillate",
        .description = "Scintillate filter",
        .optional = {"frequency", "variation_percent", "heat"},
        .optional_count = 3,
    },
    {
        .name = "brightness",
        .description = "Brightness filter",
        .optional = {"brightness"},
        .optional_count = 1,
    },
    {
        .name = "spike",
        .description = "Spike filter",
        .optional = {"color", "duration", "period", "variation", "heat", "scope"},
        .optional_count = 6,
    },
    {
        .name = "dropout",
        .description = "Dropout filter (black spike)",
        .optional = {"duration", "period", "variation", "heat", "scope"},
        .optional_count = 5,
    },
    {
        .name = "afterglow",
        .description = "Fading trails / afterglow",
        .optional = {"decay"},
        .optional_count = 1,
    },
    {
        .name = "tint",
        .description = "Color tint overlay (gel)",
        .optional = {"color", "strength"},
        .optional_count = 2,
    },
    {
        .name = "shimmer",
        .description = "Moving shimmer brightness wave",
        .optional = {"wavelength", "speed", "depth"},
        .optional_count = 3,
    },
    {
        .name = "hue_shift",
        .description = "Rotate colors' hue",
        .optional = {"speed", "offset"},
        .optional_count = 2,
    },
    {
        .name = "saturation",
        .description = "Adjust color saturation",
        .optional = {"amount"},
        .optional_count = 1,
    },
    {
        .name = "vignette",
        .description = "Dim the ends of the range",
        .optional = {"falloff", "invert"},
        .optional_count = 2,
    },
    { .name = NULL },
};

const pattern_metadata_t *metadata_get_pattern(const char *name)
{
    if (!name) return NULL;

    for (int i = 0; pattern_metadata_table[i].name != NULL; i++) {
        if (strcmp(name, pattern_metadata_table[i].name) == 0) {
            return &pattern_metadata_table[i];
        }
    }

    return NULL;
}

bool pattern_is_2d(const char *name)
{
    const pattern_metadata_t *meta = metadata_get_pattern(name);
    return meta && meta->dimensions == 2;
}

const filter_metadata_t *metadata_get_filter(const char *name)
{
    if (!name) return NULL;

    for (int i = 0; filter_metadata_table[i].name != NULL; i++) {
        if (strcmp(name, filter_metadata_table[i].name) == 0) {
            return &filter_metadata_table[i];
        }
    }

    return NULL;
}
