PeterDarley/lightmotron/c_project/components/audio/sound_manager.c

#include "sound_manager.h"
#include "audio_player.h"
#include "persistent_dict.h"
#include "json_helpers.h"
#include "cJSON.h"
#include "esp_log.h"
#include "esp_timer.h"
#include "freertos/FreeRTOS.h"
#include "freertos/task.h"
#include "freertos/semphr.h"

#include <string.h>
#include <stdlib.h>

static const char *TAG = "sound_manager";

#define MAX_PLAYING_SOUNDS 3
#define POLL_INTERVAL_MS   100  /* Matches AudioPlayer's continuous polling cadence in lib/audio.py */
#define MAX_TITLE_LEN      64

typedef struct {
    char title[MAX_TITLE_LEN];
    int module_index;
    int loops_remaining; /* Native loop_count; soundscape-driven plays force this to 0
                            since the soundscape state machine drives its own repeats. */
    int file_number;
    bool active;
} playing_sound_t;

static playing_sound_t playing_sounds[MAX_PLAYING_SOUNDS];
static SemaphoreHandle_t sound_mutex = NULL;
static TaskHandle_t poll_task_handle = NULL;
static bool initialized = false;

/* Name of the currently playing soundscape, "" if none. Mirrors
 * SoundManager._active_soundscape in lib/sounds.py. */
static char active_soundscape[MAX_TITLE_LEN] = "";

/* Per-entry soundscape progress, keyed by entry name -> object with:
 * started(bool), complete(bool), title(string), module_idx(number),
 * repeat_enabled(bool), repeat_infinite(bool), repeat_remaining(number).
 * Mirrors SoundManager._soundscape_state in lib/sounds.py. */
static cJSON *soundscape_state = NULL;

/* Minimum-loop-time support (soundscape entries with "min_loop_ticks" > 0).
 * One tick is one animation frame, 25ms (40Hz), the unit used everywhere else
 * in this project. soundscape_waiting is true while the active soundscape is
 * only waiting for a countdown/retry -- the poll task uses it to know it has
 * to re-check even though no sound just ended. */
#define SOUNDSCAPE_TICK_MS 25
#define SOUNDSCAPE_RETRY_MS 500
static bool soundscape_waiting = false;
static int64_t soundscape_retry_at_ms = 0;
static bool soundscape_advancing = false;

static int64_t now_ms(void)
{
    return esp_timer_get_time() / 1000;
}

/* Shared by get_sounds_dict()/get_soundscapes_dict(): both walk the same
 * store -> models -> current_model path and only differ in which child key
 * of the current model they return. */
static cJSON *get_current_model_child(const char *key)
{
    persistent_dict_t *store = persistent_dict_open(STORAGE_LIGHTING_SETTINGS_FILE);
    if (!store) return NULL;

    cJSON *models = persistent_dict_get(store, "models");
    cJSON *current = persistent_dict_get(store, "current_model");
    if (!models || !current || !current->valuestring) return NULL;

    cJSON *model = cJSON_GetObjectItem(models, current->valuestring);
    if (!model) return NULL;

    return cJSON_GetObjectItem(model, key);
}

static cJSON *get_sounds_dict(void)
{
    return get_current_model_child("sounds");
}

static cJSON *get_sound_by_title(const char *title)
{
    cJSON *sounds = get_sounds_dict();
    if (!sounds) return NULL;
    return cJSON_GetObjectItem(sounds, title);
}

static cJSON *get_soundscapes_dict(void)
{
    return get_current_model_child("soundscapes");
}

static cJSON *get_soundscape_by_name(const char *name)
{
    cJSON *soundscapes = get_soundscapes_dict();
    if (!soundscapes) return NULL;
    return cJSON_GetObjectItem(soundscapes, name);
}

esp_err_t sound_manager_init(void)
{
    if (initialized) return ESP_OK;

    sound_mutex = xSemaphoreCreateMutex();
    if (!sound_mutex) {
        ESP_LOGE(TAG, "Failed to create sound_mutex");
        return ESP_ERR_NO_MEM;
    }
    memset(playing_sounds, 0, sizeof(playing_sounds));
    active_soundscape[0] = '\0';
    initialized = true;

    ESP_LOGI(TAG, "Sound manager initialized");
    return ESP_OK;
}

/* Resolve and start playback of `sound` (already looked up by title), stopping
 * any sounds in its "stops" list first, then track it in playing_sounds[].
 * `loop_count` is the effective native loop count to arm; soundscape entries
 * pass 0 since the soundscape state machine (not the native loop mechanism)
 * drives their repeats. Mirrors the shared body of SoundManager.play_sound. */
static esp_err_t start_sound_playback(const char *title, cJSON *sound, int loop_count, int *out_module_idx)
{
    int file_number = json_get_int(sound, "file", 0);
    bool high_quality = json_get_bool(sound, "high_quality", false);

    cJSON *stops = cJSON_GetObjectItem(sound, "stops");
    if (stops && cJSON_IsArray(stops)) {
        for (cJSON *item = stops->child; item; item = item->next) {
            if (item->valuestring) sound_manager_stop(item->valuestring);
        }
    }

    int module_idx = audio_player_play_file(file_number, high_quality);
    if (module_idx < 0) {
        ESP_LOGW(TAG, "No module available for sound '%s'", title);
        return ESP_FAIL;
    }

    xSemaphoreTake(sound_mutex, portMAX_DELAY);

    int slot = -1;
    for (int i = 0; i < MAX_PLAYING_SOUNDS; i++) {
        if (!playing_sounds[i].active) {
            slot = i;
            break;
        }
    }
    if (slot < 0) {
        /* All slots full - stop the oldest and reuse its slot. */
        slot = 0;
        audio_player_stop_module(playing_sounds[slot].module_index);
        playing_sounds[slot].active = false;
    }

    strncpy(playing_sounds[slot].title, title, sizeof(playing_sounds[slot].title) - 1);
    playing_sounds[slot].title[sizeof(playing_sounds[slot].title) - 1] = '\0';
    playing_sounds[slot].module_index = module_idx;
    playing_sounds[slot].loops_remaining = loop_count;
    playing_sounds[slot].file_number = file_number;
    playing_sounds[slot].active = true;

    xSemaphoreGive(sound_mutex);

    ESP_LOGI(TAG, "Playing sound '%s' file=%d module=%d loops=%d",
             title, file_number, module_idx, loop_count);
    if (out_module_idx) *out_module_idx = module_idx;
    return ESP_OK;
}

esp_err_t sound_manager_play(const char *title, int loop_count_override)
{
    if (!title || !initialized) return ESP_ERR_INVALID_STATE;

    cJSON *sound = get_sound_by_title(title);
    if (!sound) {
        ESP_LOGW(TAG, "Sound not found: '%s'", title);
        return ESP_ERR_NOT_FOUND;
    }

    /* Looping is configured on soundscape entries, not on the sound itself
     * (a stored "loop_count" on a sound is ignored). */
    int loop_count = (loop_count_override > 0) ? loop_count_override : 0;

    return start_sound_playback(title, sound, loop_count, NULL);
}

esp_err_t sound_manager_stop(const char *title)
{
    if (!title || !initialized) return ESP_ERR_INVALID_STATE;

    xSemaphoreTake(sound_mutex, portMAX_DELAY);

    for (int i = 0; i < MAX_PLAYING_SOUNDS; i++) {
        if (playing_sounds[i].active && strcmp(playing_sounds[i].title, title) == 0) {
            audio_player_stop_module(playing_sounds[i].module_index);
            playing_sounds[i].active = false;
            ESP_LOGI(TAG, "Stopped sound '%s'", title);

            /* If a soundscape is active, stopping any tracked sound also ends
             * it, mirroring SoundManager.stop_sound in lib/sounds.py. */
            if (active_soundscape[0] != '\0') {
                active_soundscape[0] = '\0';
                if (soundscape_state) {
                    cJSON_Delete(soundscape_state);
                    soundscape_state = NULL;
                }
            }
            break;
        }
    }

    xSemaphoreGive(sound_mutex);
    return ESP_OK;
}

bool sound_manager_stop_verified(const char *title)
{
    if (!title || !initialized) return false;

    /* Collect candidate modules under the mutex, but do the slow hardware
     * retry loop outside it so a stubborn module (up to 5 x ~150ms) doesn't
     * stall the poll task or other callers — mirrors SoundManager.stop_sound
     * in lib/sounds.py, which also only flips state on hardware confirmation. */
    int candidates[MAX_PLAYING_SOUNDS];
    int candidate_count = 0;

    xSemaphoreTake(sound_mutex, portMAX_DELAY);
    for (int i = 0; i < MAX_PLAYING_SOUNDS; i++) {
        if (playing_sounds[i].active && strcmp(playing_sounds[i].title, title) == 0) {
            candidates[candidate_count++] = playing_sounds[i].module_index;
        }
    }
    xSemaphoreGive(sound_mutex);

    if (candidate_count == 0) return false;

    bool stopped_any = false;
    for (int c = 0; c < candidate_count; c++) {
        int module_idx = candidates[c];
        bool module_stopped = false;

        for (int attempt = 0; attempt < 5; attempt++) {
            audio_player_stop_module(module_idx);
            vTaskDelay(pdMS_TO_TICKS(150));

            /* audio_player_is_module_playing re-queries hardware status. */
            if (!audio_player_is_module_playing(module_idx)) {
                module_stopped = true;
                break;
            }
            ESP_LOGW(TAG, "stop verify module=%d attempt=%d still playing", module_idx, attempt + 1);
        }

        if (module_stopped) {
            stopped_any = true;
            xSemaphoreTake(sound_mutex, portMAX_DELAY);
            for (int i = 0; i < MAX_PLAYING_SOUNDS; i++) {
                if (playing_sounds[i].active && playing_sounds[i].module_index == module_idx &&
                    strcmp(playing_sounds[i].title, title) == 0) {
                    playing_sounds[i].active = false;
                }
            }
            /* Stopping a soundscape-driven sound ends the soundscape too. */
            if (active_soundscape[0] != '\0') {
                active_soundscape[0] = '\0';
                if (soundscape_state) {
                    cJSON_Delete(soundscape_state);
                    soundscape_state = NULL;
                }
            }
            xSemaphoreGive(sound_mutex);
            ESP_LOGI(TAG, "Verified stop of '%s' on module %d", title, module_idx);
        } else {
            ESP_LOGE(TAG, "Verified stop FAILED for '%s' on module %d (hardware still playing)",
                     title, module_idx);
        }
    }

    return stopped_any;
}

void sound_manager_stop_all(void)
{
    if (!initialized) return;

    xSemaphoreTake(sound_mutex, portMAX_DELAY);
    audio_player_stop_all();
    memset(playing_sounds, 0, sizeof(playing_sounds));
    active_soundscape[0] = '\0';
    if (soundscape_state) {
        cJSON_Delete(soundscape_state);
        soundscape_state = NULL;
    }
    xSemaphoreGive(sound_mutex);
}

bool sound_manager_is_playing(const char *title)
{
    if (!title || !initialized) return false;

    xSemaphoreTake(sound_mutex, portMAX_DELAY);
    bool found = false;
    for (int i = 0; i < MAX_PLAYING_SOUNDS; i++) {
        if (playing_sounds[i].active && strcmp(playing_sounds[i].title, title) == 0) {
            found = true;
            break;
        }
    }
    xSemaphoreGive(sound_mutex);
    return found;
}

cJSON *sound_manager_get_playing(void)
{
    cJSON *arr = cJSON_CreateArray();
    if (!initialized) return arr;

    xSemaphoreTake(sound_mutex, portMAX_DELAY);
    for (int i = 0; i < MAX_PLAYING_SOUNDS; i++) {
        if (playing_sounds[i].active) {
            cJSON_AddItemToArray(arr, cJSON_CreateString(playing_sounds[i].title));
        }
    }
    xSemaphoreGive(sound_mutex);
    return arr;
}

int sound_manager_get_playing_module(const char *title)
{
    if (!title || !initialized) return -1;

    xSemaphoreTake(sound_mutex, portMAX_DELAY);
    int module_index = -1;
    for (int i = 0; i < MAX_PLAYING_SOUNDS; i++) {
        if (playing_sounds[i].active && strcmp(playing_sounds[i].title, title) == 0) {
            module_index = playing_sounds[i].module_index;
            break;
        }
    }
    xSemaphoreGive(sound_mutex);
    return module_index;
}

/* Replace (or create) the state object tracked for a soundscape entry. */
static void set_entry_state(const char *entry_name, bool started, bool complete,
                             const char *title, int module_idx,
                             bool repeat_enabled, bool repeat_infinite, int repeat_remaining,
                             int64_t started_ms)
{
    xSemaphoreTake(sound_mutex, portMAX_DELAY);
    if (!soundscape_state) soundscape_state = cJSON_CreateObject();

    cJSON *st = cJSON_CreateObject();
    cJSON_AddBoolToObject(st, "started", started);
    cJSON_AddBoolToObject(st, "complete", complete);
    cJSON_AddStringToObject(st, "title", title ? title : "");
    cJSON_AddNumberToObject(st, "module_idx", module_idx);
    cJSON_AddBoolToObject(st, "repeat_enabled", repeat_enabled);
    cJSON_AddBoolToObject(st, "repeat_infinite", repeat_infinite);
    cJSON_AddNumberToObject(st, "repeat_remaining", repeat_remaining);
    cJSON_AddNumberToObject(st, "started_ms", (double)started_ms); /* when the sound last started, for min_loop_ticks */

    cJSON_DeleteItemFromObject(soundscape_state, entry_name);
    cJSON_AddItemToObject(soundscape_state, entry_name, st);
    xSemaphoreGive(sound_mutex);
}

static void mark_entry_complete(const char *entry_name)
{
    xSemaphoreTake(sound_mutex, portMAX_DELAY);
    if (soundscape_state) {
        cJSON *st = cJSON_GetObjectItem(soundscape_state, entry_name);
        if (st) cJSON_ReplaceItemInObject(st, "complete", cJSON_CreateBool(true));
    }
    xSemaphoreGive(sound_mutex);
}

/* Play the next runnable entry of a soundscape (first not-yet-started entry
 * whose "after" dependency, if any, has completed; or a started entry that
 * still needs to repeat). Returns true if an entry was (re)played, false if
 * the soundscape has no more work and is now complete. Mirrors
 * SoundManager._play_next_soundscape_entry in lib/sounds.py. */
static bool play_next_soundscape_entry(const char *soundscape_name)
{
    /* Re-set below only if this call ends up waiting on a min_loop_ticks
     * countdown or a busy-hardware retry. */
    soundscape_waiting = false;

    cJSON *soundscape = get_soundscape_by_name(soundscape_name);
    if (!soundscape) {
        xSemaphoreTake(sound_mutex, portMAX_DELAY);
        active_soundscape[0] = '\0';
        xSemaphoreGive(sound_mutex);
        return false;
    }

    for (cJSON *entry = soundscape->child; entry; entry = entry->next) {
        if (!cJSON_IsObject(entry)) continue;
        const char *entry_name = entry->string;
        if (!entry_name) continue;

        xSemaphoreTake(sound_mutex, portMAX_DELAY);
        cJSON *entry_state = soundscape_state ? cJSON_GetObjectItem(soundscape_state, entry_name) : NULL;
        bool is_started = entry_state && cJSON_IsTrue(cJSON_GetObjectItem(entry_state, "started"));
        bool is_complete = entry_state && cJSON_IsTrue(cJSON_GetObjectItem(entry_state, "complete"));
        xSemaphoreGive(sound_mutex);

        if (!is_started) {
            const char *after_entry = json_get_string(entry, "after", NULL);
            if (after_entry && after_entry[0] != '\0') {
                xSemaphoreTake(sound_mutex, portMAX_DELAY);
                cJSON *after_state = soundscape_state ? cJSON_GetObjectItem(soundscape_state, after_entry) : NULL;
                bool after_complete = after_state && cJSON_IsTrue(cJSON_GetObjectItem(after_state, "complete"));
                xSemaphoreGive(sound_mutex);
                if (!after_complete) continue; /* predecessor hasn't finished yet */
            }

            const char *sound_title = json_get_string(entry, "sound", "");
            int repeat_count = json_get_int(entry, "repeat", 0);
            bool repeat_enabled = cJSON_GetObjectItem(entry, "repeat_enabled")
                                       ? json_get_bool(entry, "repeat_enabled", false)
                                       : (repeat_count > 0); /* back-compat for older entries */
            bool repeat_infinite = repeat_enabled && repeat_count == 0;

            if (sound_title[0] == '\0') {
                set_entry_state(entry_name, true, true, "", -1, false, false, 0, 0);
                continue;
            }

            cJSON *sound = get_sound_by_title(sound_title);
            int module_idx = -1;
            if (!sound || start_sound_playback(sound_title, sound, 0, &module_idx) != ESP_OK) {
                ESP_LOGW(TAG, "soundscape: failed to play entry='%s' sound='%s'", entry_name, sound_title);
                set_entry_state(entry_name, true, true, "", -1, false, false, 0, 0);
                continue;
            }

            set_entry_state(entry_name, true, false, sound_title, module_idx,
                             repeat_enabled, repeat_infinite, repeat_count, now_ms());
            ESP_LOGI(TAG, "soundscape: playing entry='%s' sound='%s' repeat_enabled=%d infinite=%d count=%d",
                     entry_name, sound_title, repeat_enabled, repeat_infinite, repeat_count);
            return true;
        }

        if (is_complete) continue;

        /* Entry already started - check if it needs to repeat. */
        xSemaphoreTake(sound_mutex, portMAX_DELAY);
        cJSON *st = cJSON_GetObjectItem(soundscape_state, entry_name);
        bool repeat_enabled = st && cJSON_IsTrue(cJSON_GetObjectItem(st, "repeat_enabled"));
        bool repeat_infinite = st && cJSON_IsTrue(cJSON_GetObjectItem(st, "repeat_infinite"));
        int repeat_remaining = st ? json_get_int(st, "repeat_remaining", 0) : 0;
        double last_started_ms = st ? json_get_double(st, "started_ms", 0.0) : 0.0;
        char sound_title[MAX_TITLE_LEN] = "";
        if (st) strncpy(sound_title, json_get_string(st, "title", ""), sizeof(sound_title) - 1);
        xSemaphoreGive(sound_mutex);

        if (!repeat_enabled) {
            mark_entry_complete(entry_name);
            continue;
        }

        if (repeat_infinite || repeat_remaining > 0) {
            /* Minimum loop time: the next play may not start until this many
             * ticks after the previous one *started*. 0 = no countdown, repeat
             * as soon as the sound ends (the original behavior). Read live from
             * the entry so edits apply without restarting the soundscape. This
             * entry keeps the soundscape's turn while it waits -- later entries
             * don't start until it's done repeating, same as without a timer. */
            int min_loop_ticks = json_get_int(entry, "min_loop_ticks", 0);
            bool has_min_loop = min_loop_ticks > 0;
            if (has_min_loop) {
                int64_t due_ms = (int64_t)last_started_ms + (int64_t)min_loop_ticks * SOUNDSCAPE_TICK_MS;
                int64_t now = now_ms();
                if (now < due_ms || now < soundscape_retry_at_ms) {
                    soundscape_waiting = true; /* still counting down (or backing off a busy retry) */
                    return true;
                }
            }

            cJSON *sound = get_sound_by_title(sound_title);
            int module_idx = -1;
            if (!sound || start_sound_playback(sound_title, sound, 0, &module_idx) != ESP_OK) {
                if (sound && has_min_loop) {
                    /* Countdown is done but no module is free (another sound
                     * is still using the hardware): wait for it and try
                     * again shortly instead of giving up on the entry. */
                    soundscape_retry_at_ms = now_ms() + SOUNDSCAPE_RETRY_MS;
                    soundscape_waiting = true;
                    return true;
                }
                ESP_LOGW(TAG, "soundscape: failed to repeat entry='%s'", entry_name);
                mark_entry_complete(entry_name);
                continue;
            }
            soundscape_retry_at_ms = 0;

            xSemaphoreTake(sound_mutex, portMAX_DELAY);
            cJSON *st2 = cJSON_GetObjectItem(soundscape_state, entry_name);
            if (st2) {
                cJSON_ReplaceItemInObject(st2, "started_ms", cJSON_CreateNumber((double)now_ms()));
                cJSON_ReplaceItemInObject(st2, "module_idx", cJSON_CreateNumber(module_idx));
                if (!repeat_infinite) {
                    int remaining = repeat_remaining - 1;
                    cJSON_ReplaceItemInObject(st2, "repeat_remaining", cJSON_CreateNumber(remaining));
                    if (remaining <= 0) {
                        cJSON_ReplaceItemInObject(st2, "complete", cJSON_CreateBool(true));
                    }
                }
            }
            xSemaphoreGive(sound_mutex);

            ESP_LOGI(TAG, "soundscape: repeating entry='%s' sound='%s' infinite=%d remaining=%d",
                     entry_name, sound_title, repeat_infinite, repeat_remaining - 1);
            return true;
        }

        mark_entry_complete(entry_name);
    }

    /* No more entries to play. */
    ESP_LOGI(TAG, "soundscape: complete name='%s'", soundscape_name);
    xSemaphoreTake(sound_mutex, portMAX_DELAY);
    active_soundscape[0] = '\0';
    if (soundscape_state) {
        cJSON_Delete(soundscape_state);
        soundscape_state = NULL;
    }
    xSemaphoreGive(sound_mutex);
    return false;
}

/* Advance the active soundscape (if any) once, unless another task is already
 * doing so -- the poll task (countdown/retry) and the web status self-heal in
 * sound_manager_get_active_soundscape() could otherwise both decide it's time
 * and start the same repeat twice. */
static void advance_active_soundscape(void)
{
    char name_copy[MAX_TITLE_LEN];

    xSemaphoreTake(sound_mutex, portMAX_DELAY);
    if (soundscape_advancing || active_soundscape[0] == '\0') {
        xSemaphoreGive(sound_mutex);
        return;
    }
    soundscape_advancing = true;
    strncpy(name_copy, active_soundscape, sizeof(name_copy) - 1);
    name_copy[sizeof(name_copy) - 1] = '\0';
    xSemaphoreGive(sound_mutex);

    play_next_soundscape_entry(name_copy);

    xSemaphoreTake(sound_mutex, portMAX_DELAY);
    soundscape_advancing = false;
    xSemaphoreGive(sound_mutex);
}

esp_err_t sound_manager_play_soundscape(const char *name)
{
    if (!name || !initialized) return ESP_ERR_INVALID_STATE;

    soundscape_waiting = false;
    soundscape_retry_at_ms = 0;

    cJSON *soundscape = get_soundscape_by_name(name);
    if (!soundscape) {
        ESP_LOGW(TAG, "soundscape: not found name='%s'", name);
        return ESP_ERR_NOT_FOUND;
    }

    sound_manager_stop_all();

    xSemaphoreTake(sound_mutex, portMAX_DELAY);
    strncpy(active_soundscape, name, sizeof(active_soundscape) - 1);
    active_soundscape[sizeof(active_soundscape) - 1] = '\0';
    if (soundscape_state) cJSON_Delete(soundscape_state);
    soundscape_state = cJSON_CreateObject();
    xSemaphoreGive(sound_mutex);

    ESP_LOGI(TAG, "soundscape: start name='%s'", name);
    play_next_soundscape_entry(name);
    return ESP_OK;
}

const char *sound_manager_get_active_soundscape(void)
{
    if (active_soundscape[0] == '\0') return "";

    /* Self-heal stale state: if nothing is playing on any module, the
     * soundscape should have advanced already - do it now. Mirrors
     * SoundManager.get_active_soundscape in lib/sounds.py. */
    bool any_playing = false;
    xSemaphoreTake(sound_mutex, portMAX_DELAY);
    for (int i = 0; i < MAX_PLAYING_SOUNDS; i++) {
        if (playing_sounds[i].active) {
            any_playing = true;
            break;
        }
    }
    xSemaphoreGive(sound_mutex);

    if (!any_playing) {
        advance_active_soundscape();
    }

    return active_soundscape;
}

/* Handle end-of-playback for a sound: native loop, soundscape advancement, or
 * chain_next, in that priority order. Mirrors SoundManager.handle_sound_ended
 * in lib/sounds.py. */
static void handle_sound_ended(const char *title, int module_idx, int file_number, int loops_remaining)
{
    if (loops_remaining > 0) {
        int new_module = audio_player_play_file(file_number, false);

        xSemaphoreTake(sound_mutex, portMAX_DELAY);
        for (int i = 0; i < MAX_PLAYING_SOUNDS; i++) {
            if (playing_sounds[i].active && playing_sounds[i].module_index == module_idx &&
                strcmp(playing_sounds[i].title, title) == 0) {
                if (new_module >= 0) {
                    playing_sounds[i].module_index = new_module;
                    playing_sounds[i].loops_remaining = loops_remaining - 1;
                } else {
                    playing_sounds[i].active = false;
                }
                break;
            }
        }
        xSemaphoreGive(sound_mutex);
        ESP_LOGD(TAG, "sound: loop title='%s' remaining=%d", title, loops_remaining - 1);
        return;
    }

    /* No more native loops - free this slot before considering soundscape/chain. */
    xSemaphoreTake(sound_mutex, portMAX_DELAY);
    for (int i = 0; i < MAX_PLAYING_SOUNDS; i++) {
        if (playing_sounds[i].active && playing_sounds[i].module_index == module_idx &&
            strcmp(playing_sounds[i].title, title) == 0) {
            playing_sounds[i].active = false;
            break;
        }
    }
    xSemaphoreGive(sound_mutex);

    /* Soundscape advancement takes priority over chaining, but only when the
     * sound that ended matches an active (not-yet-complete) soundscape entry. */
    if (active_soundscape[0] != '\0') {
        bool matched = false;

        xSemaphoreTake(sound_mutex, portMAX_DELAY);
        if (soundscape_state) {
            for (cJSON *entry_state = soundscape_state->child; entry_state; entry_state = entry_state->next) {
                if (cJSON_IsTrue(cJSON_GetObjectItem(entry_state, "complete"))) continue;
                const char *expected_title = json_get_string(entry_state, "title", "");
                int expected_module = json_get_int(entry_state, "module_idx", -1);
                if (strcmp(expected_title, title) == 0 &&
                    (expected_module < 0 || expected_module == module_idx)) {
                    matched = true;
                    break;
                }
            }
        }
        char name_copy[MAX_TITLE_LEN];
        strncpy(name_copy, active_soundscape, sizeof(name_copy) - 1);
        name_copy[sizeof(name_copy) - 1] = '\0';
        xSemaphoreGive(sound_mutex);

        if (matched) {
            play_next_soundscape_entry(name_copy);
            return;
        }
    }

    /* Sequencing/chaining is done by soundscapes -- sounds no longer chain on
     * their own. */
    ESP_LOGD(TAG, "sound: ended title='%s' module=%d", title, module_idx);
}

static void poll_task(void *arg)
{
    typedef struct {
        char title[MAX_TITLE_LEN];
        int module_index;
        int file_number;
        int loops_remaining;
    } ended_sound_t;

    while (1) {
        vTaskDelay(pdMS_TO_TICKS(POLL_INTERVAL_MS));

        ended_sound_t ended[MAX_PLAYING_SOUNDS];
        int ended_count = 0;

        xSemaphoreTake(sound_mutex, portMAX_DELAY);
        for (int i = 0; i < MAX_PLAYING_SOUNDS; i++) {
            if (!playing_sounds[i].active) continue;
            if (!audio_player_is_module_playing(playing_sounds[i].module_index)) {
                strncpy(ended[ended_count].title, playing_sounds[i].title, MAX_TITLE_LEN - 1);
                ended[ended_count].title[MAX_TITLE_LEN - 1] = '\0';
                ended[ended_count].module_index = playing_sounds[i].module_index;
                ended[ended_count].file_number = playing_sounds[i].file_number;
                ended[ended_count].loops_remaining = playing_sounds[i].loops_remaining;
                ended_count++;
            }
        }
        xSemaphoreGive(sound_mutex);

        /* Handle side effects (loop/soundscape/chain) outside the lock so they
         * can freely call back into sound_manager_* helpers. */
        for (int i = 0; i < ended_count; i++) {
            handle_sound_ended(ended[i].title, ended[i].module_index,
                                ended[i].file_number, ended[i].loops_remaining);
        }

        /* A soundscape entry waiting out its min_loop_ticks countdown (or
         * retrying for a free module) has no sound-ended event to wake it, so
         * re-check it here every poll. */
        if (soundscape_waiting) {
            advance_active_soundscape();
        }
    }
}

esp_err_t sound_manager_start_polling(void)
{
    if (poll_task_handle) return ESP_OK;

    xTaskCreate(poll_task, "snd_poll", 3072, NULL, 3, &poll_task_handle);
    return ESP_OK;
}
