PeterDarley/lightmotron/c_project/components/lighting/include/lighting.h

#ifndef LIGHTING_H
#define LIGHTING_H

#include "esp_err.h"
#include "leds.h"
#include "cJSON.h"

#include <stdbool.h>
#include <stdint.h>

/* Maximum concurrent active scenes */
#define MAX_ACTIVE_SCENES 8
#define MAX_JOBS_PER_SCENE 16

#ifndef MAX_LEDS
#define MAX_LEDS 300
#endif

/**
 * LED output entry from a pattern function.
 */
typedef struct {
    int led_index;
    rgb_t color;
} led_output_t;

/* Max number of independently-timed LED groups a spike/dropout filter can
 * track (scope "all" = 1 group, "subranges" = contiguous LED runs, anything
 * else = one group per LED). Groups beyond this cap share the last slot. */
#define MAX_SPIKE_GROUPS 8

/**
 * Per-group periodic spike timing state (mirrors the Python "_state" dict
 * used by lighting.filters._apply_spike_filter).
 */
typedef struct {
    int next_spike;
    int spike_end;
    bool initialized;
} spike_group_state_t;

/**
 * Filter runtime state (per-effect instance).
 */
typedef struct {
    spike_group_state_t spike_groups[MAX_SPIKE_GROUPS];
    void *cached_params; /* Reserved for filters that need modified params */
    /* sizzle/scintillate: persistent per-channel deviation ratio, stepped
     * incrementally each update rather than redrawn from scratch each time
     * -- see step_deviation() in filters.c. sizzle shares one walk across
     * every LED (shared_deviation); scintillate gives each LED its own,
     * heap-allocated lazily and sized to the job's actual LED count since
     * embedding a MAX_LEDS*3 float array in every filter slot regardless
     * of filter type would be a large fixed cost repeated per job/scene
     * slot (see BUILD_NOTES.md's DRAM overflow history for why that's a
     * real concern here, not a theoretical one). Freed in
     * free_job_filters() alongside cached_params. */
    float shared_deviation[3];
    float *per_led_deviation;
    int per_led_deviation_count;
} filter_state_t;

/**
 * Active job state within a scene.
 */
typedef struct {
    char name[64];
    char pattern_name[32];
    rgb_t colors[8];
    int color_count;
    int target_indices[MAX_LEDS];
    int target_count;
    int duration;
    int cycles;
    int cycles_completed;
    int period;
    int width;
    int number;
    bool reverse;
    /* Additional per-pattern params (mirror effect.get(...) reads in the
     * Python patterns). Defaults are applied in effect_resolve(): saturation
     * for rainbow, cooling/sparking for fire, spacing for theater_chase. */
    float saturation; /* rainbow, 0.0-1.0 */
    int cooling;      /* fire */
    int sparking;     /* fire */
    int spacing;      /* theater_chase */
    float ball_radius; /* bouncing_ball: glow falloff radius, in grid cells */
    /* For a 2D pattern only: the shape target_indices[] is laid out in
     * (row * grid_width + col, value = LED index or -1 for a gap), set by
     * range_topology_resolve(). Meaningless/0 for a 1D job. */
    int grid_width;
    int grid_height;
    uint32_t start_tick;
    bool finished;
    char after[64];          /* Job name this depends on */
    bool after_pending;      /* True until the "after" dependency has been satisfied once */
    bool inherit_target;     /* With "after": adopt the finished predecessor's resolved
                                target instead of this job's own (mirrors Python's
                                inherit_target/passthrough in effects.py) */
    /* Retained per-cycle random state used by patterns that need a value to
     * persist across ticks within the same cycle (mirrors Python's
     * Lighting.retained_values dict). Currently only pattern_phaser_strip's
     * random meeting point uses this. */
    int retained_meet_index;
    bool retained_meet_set;
    /* Filter chain */
    struct {
        char filter_name[32];
        cJSON *params;
        filter_state_t state;
    } filters[8];
    int filter_count;
} active_job_t;

/**
 * Active scene state.
 */
typedef struct {
    char name[64];
    active_job_t jobs[MAX_JOBS_PER_SCENE];
    int job_count;
    bool active;
} active_scene_t;

/**
 * Initialize the lighting system.
 */
esp_err_t lighting_init(void);

/**
 * Process a single animation tick.
 *
 * Called by the animation task each frame.
 */
void lighting_process_tick(uint32_t tick);

/**
 * Set (activate) a scene by name. Clears existing scenes first.
 */
esp_err_t lighting_set_scene(const char *scene_name);

/**
 * Add a scene to the active set (without clearing others).
 */
esp_err_t lighting_add_scene(const char *scene_name);

/**
 * Activate every scene marked scene_settings.<name>.active_on_boot in the
 * current model. If none are marked, falls back to lighting_set_scene(NULL)
 * (the model's "default_scene", else the first defined scene). Call once
 * after lighting_init(), and again after switching models.
 */
esp_err_t lighting_activate_boot_scenes(void);

/**
 * Remove a scene from the active set.
 */
esp_err_t lighting_remove_scene(const char *scene_name);

/**
 * Get list of currently active scene names.
 */
int lighting_get_active_scenes(char names[][64], int max_count);

/**
 * Clear all active scenes.
 */
void lighting_clear_scenes(void);

/* Default power supply rating in amps (System Settings → Power Supply). */
#define DEFAULT_POWER_SUPPLY_AMPS 3

/**
 * Worst-case LED current across all saved scenes, in amps (LEDs only).
 */
float lighting_estimate_led_amps(void);

/**
 * Logs the estimated peak draw (LEDs + 0.5A system) against the configured
 * power supply. Called on every scene save.
 */
void lighting_report_power_estimate(void);

/**
 * Recalculates the cached peak-draw estimate (no logging).
 */
void lighting_update_power_estimate(void);

/**
 * Cached LED peak draw (amps) and power supply rating (amps), from the last
 * update. Cheap to call; the status page reads these.
 */
float lighting_get_cached_led_amps(void);
float lighting_get_cached_supply_amps(void);

/**
 * The built-in "All Dark" pseudo scene (not stored in the scene list): stops
 * every running scene and sets every LED to 0,0,0. Nothing is left running,
 * so the LEDs stay dark until another scene is started.
 */
void lighting_all_dark(void);

/** Name the Home page uses for the All Dark pseudo scene button. */
#define LIGHTING_ALL_DARK_NAME "All Dark"

/**
 * Get the logical color buffer (current LED state).
 */
rgb_t *lighting_get_logical_colors(void);

/**
 * Resolve a target specification to LED indices.
 *
 * Supports: "0-5", "10-20", "named:RangeName", comma-separated combos.
 * Returns number of indices resolved.
 */
int lighting_get_targets(const char *spec, int *indices, int max_indices);

/**
 * Resolve a color specification to an RGB value.
 *
 * Supports: named colors, "#RRGGBB" hex, [r, g, b] arrays.
 */
rgb_t lighting_get_color(const char *spec);

/**
 * Resolve a color from a cJSON value.
 */
rgb_t lighting_get_color_json(const cJSON *color_spec);

/**
 * Get model names list.
 */
cJSON *lighting_get_model_names(void);

/**
 * Get current model name.
 */
const char *lighting_get_current_model(void);

/**
 * Set the current model.
 */
esp_err_t lighting_set_current_model(const char *model_name);

/**
 * Get the current model's settings object.
 */
cJSON *lighting_get_settings(void);

/**
 * Create a new model. If copy_from_current is true, the current model's
 * scenes/effects/filters/named_ranges/custom_colors/scene_settings are
 * deep-copied into the new model; otherwise it starts empty.
 */
esp_err_t lighting_create_model(const char *model_name, bool copy_from_current);

/**
 * Delete a model. Fails if it is the currently active model.
 */
esp_err_t lighting_delete_model(const char *model_name);

/**
 * Rename a model, updating current_model if it was the active one.
 */
esp_err_t lighting_rename_model(const char *old_name, const char *new_name);

#endif /* LIGHTING_H */
