PeterDarley/lightmotron/(commit log)

2026-03-22 Implement animation controls and scene selection: add buttons for starting/stopping animations and selecting scenes
2026-03-27 Add status and LED picker views; enhance setup page with LED naming functionality
2026-03-27 Refactor LED naming functionality with new toggle and clear routes; update setup and LED picker templates for improved interaction
2026-03-28 Add detailed lighting system documentation, including scene configuration, target specifications, color definitions, patterns, and filters
2026-04-01 Update default COM port from COM3 to COM4 in REPL and upload scripts; add new binary files for ESP32 and update documentation images.
2026-04-01 Implement LED range editing functionality: add NamedRangeEditView, update routes, and create led_picker_edit.html template
2026-04-01 Refactor LED picker functionality: consolidate JavaScript logic into led_picker.js, enhance user instructions in setup.html, and add NamedRangeSetView for managing LED selections.
2026-04-01 Refactor LED range management: update led_picker.html for improved range editing, remove led_picker_edit.html, and streamline routes in routes.py
2026-04-09 Refactor delete button for custom colors to use htmx for better interaction
2026-04-10 Update target parameter format in pattern_params.html and improve error handling in StorageView
    [views.py]
2026-04-10 Refactor scene management to replace job terminology with effects, updating templates and backend logic accordingly
    [views.py]
2026-04-16 Implement filter management: add filter creation, editing, and summary features
2026-04-18 Add lighting filter design guidelines to Copilot instructions
2026-04-20 Implement theming support: add theme classes to buttons and panels, create theme context processor, and add theme selection functionality
2026-04-20 Enhance LCARS theme styles with new color palette and improved component structure
    - Added a comprehensive color palette for LCARS theme with 20 distinct colors.
    - Refactored navbar styles for better consistency and responsiveness.
    - Improved card component styles, including headers, bodies, and footers.
    - Implemented per-card color cycling for enhanced visual variety.
    - Updated button styles for ongoing, immediate, start, and stop actions to ensure better user interaction.
    - Enhanced input and table styles for improved usability and aesthetics.
    - Refined modal and list group styles for better integration within the theme.
    - Consolidated nested card styles to maintain consistency across comp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
2026-04-20 Add single LEDs image to documentation
2026-04-21 Add sound effects support and enhance theming documentation
    - Introduced SoundManager class for handling audio playback based on CSS variables.
    - Added sound files for button interactions and navigation.
    - Updated theming documentation to include new sound effects and navigation styling.
    - Enhanced form controls with theme-specific classes for better styling.
    - Included new sound files for various interactions.
2026-04-21 Update README.md to enhance lighting system documentation and add web interface usage details; create internals.md for technical specifications of patterns and filters
2026-04-21 Enhance README.md with detailed web interface documentation, including Home, Setup, Status, and Storage pages, along with custom colors, named ranges, filters, effects, scenes, and theme options.
2026-04-24 Add audio module support and enhance sound management features
    - Updated README.md to include audio module functionality and sound management.
    - Added new settings_template.py for persistent storage structure reference.
    - Introduced sounds management in the setup page with a dedicated card.
    - Created sounds.html and sounds_summary.html templates for sound configuration.
    - Implemented backend routes and views for sound management, including playing sounds.
    - Enhanced CSS styles for new sound sections and buttons across themes.
    - Added MP3 files and audio player configuration options in system settings.
2026-05-04 Enhance robustness of scene label construction and audio player configuration; handle non-string entries and missing values gracefully
    [views.py]
2026-05-05 Implement multi-model support: add Models management UI, update settings structure, and enhance LED picker functionality
2026-05-11 Add instructions for using a logic level converter with ESP32-S3 and MAX7219
2026-05-17 Add delayed reset functionality after successful updates in UpdatesView
    [views.py]
2026-05-20 Refactor LED picker and named range handling; enhance UI and server sync
2026-05-21 Enhance documentation and UI responsiveness
    - Updated README.md to clarify immediate scenes visibility and responsive card layout in Setup and Status pages.
    - Improved internal documentation in internals.md regarding static asset caching and LED picker template versioning.
    - Enhanced theming documentation to include status card and table presentation styles.
    - Modified buttons.html to conditionally display the Immediate section based on scene configuration.
    - Refined setup.html to implement a responsive grid layout for dashboard cards and added scrolling for tall summaries.
    - Updated led_picker.html to include a version query parameter for the LED picker script to manage caching.
    - Improved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
2026-05-21 Enhance effect and filter management UI; add dynamic filter display and color contrast for named ranges
2026-05-21 Implement copy functionality for storage content; enhance button feedback and fallback mechanism
2026-05-22 Refactor scene handling in Home UI; update scene panel rendering and filter parameters
2026-05-23 Enhance audio features: implement sound playback controls, add audio reset on boot, and improve upload script with retry logic
    [routes.py, settings_template.py, views.py]
2026-05-23 Refactor audio initialization in boot process: streamline import and instantiation of AudioPlayer, removing redundant error handling and logging.
    [boot.py]
2026-05-23 Refactor boot process: remove unused I2CManager import, optimize PersistentDict usage for system settings and WiFi credentials retrieval. Add utility function to normalize form values into a list in 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
2026-05-24 Enhance documentation and UI for sound and scene management
    - Updated README.md to include new scene-level behaviors and status page details.
    - Modified boot.py to initiate continuous audio polling during boot.
    - Expanded internals.md with detailed audio diagnostics and new sound playback features.
    - Updated settings_template.py to include new sound properties: loop, stops, and next_sound.
    - Refined models.html for better sound management UI, including edit and delete options.
    - Enhanced scene_edit.html to allow stopping sounds on scene start and end.
    - Created sound_edit.html for editing sound properties, including looping and chaining options.
    - Improved sounds.html to display sound list w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
2026-05-28 Update build_deployment.py to set default filesystem size for ESP32-S3 and improve error handling
    [build_deployment.py]
2026-05-28 feat: Enhance soundscape management and scene triggering functionality
    - Added soundscape creation, editing, and deletion capabilities in the setup interface.
    - Implemented soundscape summary display in the setup card.
    - Introduced trigger scenes functionality to allow automatic scene transitions upon completion.
    - Updated HTML templates for soundscapes and scenes to reflect new features.
    - Improved error handling and user feedback for soundscape operations.
    - Refactored views to support new soundscape routes and functionalities.
    [boot.py, routes.py, views.py]
2026-05-31 feat: Improve sound stopping functionality and error handling in StopSoundView
    [views.py]
2026-05-31 Duplicated lightmotron in C
    [partitions.csv]
2026-06-01 docs: Update hardware board description in Copilot instructions
2026-06-01 docs: Update hardware specifications and add image for YD-ESP32-S3 board
2026-06-01 feat: Enhance error handling and resource management in various components
    [billboard.c, lighting.c, max7219.c, sound_manager.c]
2026-06-06 feat: Add IP last octet flashing functionality with onboard LED indication
2026-07-07 Enhance webserver request handling and template engine
    - Added `is_http_1_1` flag to `http_request` structure to track HTTP version.
    - Improved URL decoding to validate hex digits in percent-encoded strings.
    - Updated multipart parsing to handle missing content types and ensure file uploads are correctly identified.
    - Enhanced template engine to properly process conditionals, variables, and includes in loop iterations, ensuring correct context resolution.
    - Refactored loop processing to match Python's behavior for iterable handling, including support for non-array types.
    [animation.c, audio_player.c, billboard.c, billboard.h, colors.c, colors.h]
2026-07-21 feat(webserver): enhance webserver functionality and improve template rendering
    - Updated CMakeLists.txt to require esp_netif for network interface management.
    - Refactored webserver.h to change template rendering function to return an HTTP response.
    - Improved request_parser.c to handle multi-value form fields and adjust behavior for oversized request bodies.
    - Enhanced template_engine.c to ensure proper handling of string literals and conditionals.
    - Modified webserver.c to improve response handling and manage connection persistence based on HTTP version.
    - Added support for flashing the last octet of the device's IP address using onboard LED in boot.c.
    - Introduced a new settings.h defini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
2026-07-24 feat: Enhance OTA update and firmware versioning
    - Added FIRMWARE_VERSION definition in CMakeLists.txt to embed the current commit/tag for OTA updates.
    - Updated ota_update.c to strip leading 'v' from version strings for consistent comparison with GitHub releases.
    - Integrated esp_crt_bundle for secure HTTPS connections during OTA updates.
    - Improved captive portal functionality by initializing and controlling onboard LED indicators.
    - Refactored persistent_dict.h to clarify storage paths and ensure separation of user data from web assets.
    - Enhanced web views to include summary contexts for named ranges, scenes, effects, and filters, improving setup page performance.
    - Updated system settin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
    [partitions.csv]
2026-07-24 feat(audio): clarify deadlock risk analysis and confirm resolution with current UART config
2026-07-24 feat(firmware): add firmware update section with current and latest version display
2026-07-24 Enhance webserver and asset management
    - Implemented an in-RAM asset cache for web assets to improve performance and avoid flash read delays during requests.
    - Added a function to cache files from the SPIFFS partition, allowing for faster access to templates and static files.
    - Updated the webserver to serve files from the asset cache, reducing flash access and improving response times.
    - Introduced a mechanism to limit concurrent client handler tasks to prevent internal RAM exhaustion.
    - Enhanced the HTTP POST handling in the captive portal to ensure complete body reception before processing.
    - Added new filter parameters in the setup HTML templates for better user control over effects.
    - U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
    [boot.c, colors.c, colors.h, effects.c, filters.c]
2026-07-24 feat(docs): update internal documentation with new lighting effects and filters
    - Added detailed descriptions for new lighting effects: Rainbow, Color Wipe, Fire, Gradient, Warp Pulse, Theater Chase, and Heartbeat.
    - Expanded filter documentation to include Afterglow, Tint, Shimmer, Hue Shift, Saturation, and Vignette.
    - Revised README to reflect new effects and filters.
    - Updated build notes to confirm successful flashing with the current partition layout.
    - Adjusted sync notes to indicate fixes for known gaps in WiFi timeout and status reporting.
    - Enhanced project plan with details on asset caching and task management.
2026-07-27 feat(named_ranges): add reorder functionality for named ranges
    - Introduced a new endpoint for reordering named ranges, allowing users to adjust the physical order of LED strings.
    - Implemented a queue system to manage selected ranges for reordering, ensuring no overlaps occur.
    - Added a new HTML template for the reorder interface, providing a user-friendly way to manage string order.
    - Enhanced existing views and models to support the new reordering logic, including validation for eligible ranges.
    - Updated scene settings to allow marking scenes as active on boot, ensuring they activate automatically when the device starts.
    - Improved LED index remapping to accommodate changes in range orde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
2026-08-03 feat: add per-segment LED color order support
    - Introduced a new feature allowing different color orders for LED-index ranges within a single strip.
    - Updated `strip_segment_config_t` and `strip_config_t` structures to accommodate segment configurations.
    - Implemented parsing and validation for segment data in both Python and C components.
    - Enhanced the web interface to manage LED segments, including dynamic dropdowns for strip selection and color order.
    - Added logging for debugging LED color outputs during initialization.
    - Updated documentation to reflect new segment configuration options.
2026-08-05 Add audio synchronization notes, remove LED hardware notes, and introduce voice control ideas
    - Created AUDIO_SYNC_NOTES.md to document the design considerations for synchronizing audio with lighting scenes, including the problem, options considered, and recommended design.
    - Deleted LED_HARDWARE_NOTES.md as the root cause of the LED strip issue has been confirmed and no further investigation is needed.
    - Added VOICE_CONTROL_NOTES.md to outline the feasibility and hardware requirements for implementing voice control using the ESP32-S3 and recommended microphone options.
    - Enhanced sound_manager.c and leds.c to include error handling for mutex creation failures.
    - Increased stack size for the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
    [animation.c, boot.c, effects.c, effects.h, leds.c, lighting.c]
2026-08-06 Migrate "data" and "webassets" partitions from SPIFFS to LittleFS in partitions.csv; update sdkconfig.defaults to increase ESP interrupt watchdog timeout to 8000ms and adjust LittleFS lookahead/cache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
    [partitions.csv]
2026-08-07 Add programming guide for effects, sounds, and scenes; update settings template documentation
    - Introduced a comprehensive programming guide detailing the configuration of lighting patterns, filters, sounds, and scenes via the web interface.
    - Updated the settings template documentation to clarify the management of persistent storage and the use of built-in firmware defaults.
2026-08-07 feat: resolve GPIO conflict in MAX7219 initialization and enhance sizzle/scintillate filters
    [boot.c, filters.c, lighting.c, lighting.h, max7219.c]
2026-09-23 Enhance JSON file handling and persistent dictionary management
    - Introduced a dedicated writer task for JSON file operations to ensure atomic writes and prevent crashes during flash operations.
    - Updated json_write_file() to utilize a temporary file approach for safer writes, with recovery mechanisms for incomplete operations.
    - Added version tracking in persistent_dict_t to allow consumers to detect changes without polling.
    - Improved scene settings update logic to handle independent form submissions, preventing unintended data loss.
    - Enhanced delete confirmation modal to dynamically include necessary fields for various delete actions.
    - Updated CSS for better visibility of close buttons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
    [boot.c, lighting.c, views_scenes.c, views_system.c]
2026-09-24 Add "All Dark" pseudo scene functionality and improve setup page refresh
    - Implemented a new function `lighting_all_dark()` to stop all running scenes and turn off all LEDs.
    - Added a button for the "All Dark" scene on the Home page for immediate access.
    - Enhanced the setup page to refresh summary cards dynamically after changes are made.
    - Updated sound and soundscape management by removing looping and chaining options from the sound edit interface, moving these functionalities to soundscapes.
    - Introduced a minimum loop time feature for soundscape entries, allowing for more control over playback timing.
    - Improved the user interface for soundscape entry management, including renaming and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
2026-10-03 Added schematic and board layouts for the hardware.
    [double.kicad_pcb, double.kicad_sch, hardware.kicad_pcb, hardware.kicad_sch, mini.kicad_pcb, mini.kicad_sch]
2026-10-04 Refactor hardware footprint paths, remove unused footprints, and enhance setup scripts
    - Updated the path for the local footprint library in `fp-lib-table` to point to shared custom footprints.
    - Deleted unused footprint files for `BSS138_LevelShifter_4ch_2x06_P2.54mm_Row10.16mm` and `YD-ESP32-S3_DevKit_2x22_P2.54mm`.
    - Added a fetch call in `setup.html` to resume animations when the setup modal closes.
    - Changed the display index for LED buttons in `led_picker.html` for better user experience.
    - Introduced a new PowerShell script `find_esp32_port.ps1` to list and probe ESP32 serial ports, improving development workflow.
2026-10-04 feat: Add power supply management and LED brightness control
    - Implemented power supply rating management with default values.
    - Added functions to estimate LED current draw and report power estimates.
    - Introduced a new endpoint for adjusting global LED brightness, stored in system settings.
    - Updated the UI to include brightness control and power supply settings.
    - Enhanced logging for estimated peak draw against configured power supply.
    - Added CSS for a new Nautilus theme, including custom font and styling for UI elements.
2026-10-10 feat: Improve soundscape controls by adding 'Stop All Sounds' button and refactoring button layout
2026-11-10 Add 2D layout configuration for named ranges
    - Introduced a new HTML template for configuring the 2D layout of LED ranges.
    - Implemented a form to manage rows, gaps, LED counts, and directions.
    - Added JavaScript functions to handle dynamic row addition and renumbering.
    - Included error and success message displays for user feedback.
